joshua-naidoo/NIFLS/Hardware/Baseplate/BASEPLATE_CAD_Package_Revision_C/LED_and_resistor_coordinates.csv

type | ID | string_ID | x_mm | y_mm | hole_spacing_mm | hole_diameter_mm
LED | D1 | S1 | -67.5 | -66.0 | 2.54 | 1.1
LED | D2 | S1 | -67.5 | -49.5 | 2.54 | 1.1
LED | D3 | S1 | -67.5 | -33.0 | 2.54 | 1.1
LED | D4 | S2 | -67.5 | -16.5 | 2.54 | 1.1
LED | D5 | S2 | -67.5 | 0.0 | 2.54 | 1.1
LED | D6 | S2 | -67.5 | 16.5 | 2.54 | 1.1
LED | D7 | S3 | -67.5 | 33.0 | 2.54 | 1.1
LED | D8 | S3 | -67.5 | 49.5 | 2.54 | 1.1
LED | D9 | S3 | -67.5 | 66.0 | 2.54 | 1.1
resistor | R1 | S1 | -67.5 | -72.5 | 10 | 1.1
resistor | R2 | S2 | -67.5 | -23.0 | 10 | 1.1
resistor | R3 | S3 | -67.5 | 26.5 | 10 | 1.1
LED | D10 | S4 | -54.0 | -66.0 | 2.54 | 1.1
LED | D11 | S4 | -54.0 | -49.5 | 2.54 | 1.1
LED | D12 | S4 | -54.0 | -33.0 | 2.54 | 1.1
LED | D13 | S5 | -54.0 | -16.5 | 2.54 | 1.1
LED | D14 | S5 | -54.0 | 0.0 | 2.54 | 1.1
LED | D15 | S5 | -54.0 | 16.5 | 2.54 | 1.1
LED | D16 | S6 | -54.0 | 33.0 | 2.54 | 1.1
LED | D17 | S6 | -54.0 | 49.5 | 2.54 | 1.1
LED | D18 | S6 | -54.0 | 66.0 | 2.54 | 1.1
resistor | R4 | S4 | -54.0 | -72.5 | 10 | 1.1
resistor | R5 | S5 | -54.0 | -23.0 | 10 | 1.1
resistor | R6 | S6 | -54.0 | 26.5 | 10 | 1.1
LED | D19 | S7 | -40.5 | -66.0 | 2.54 | 1.1
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
