joshua-naidoo/NIFLS/Hardware/Baseplate/BASEPLATE_CAD_Package_Revision_C/NIFLS_battery_access.png

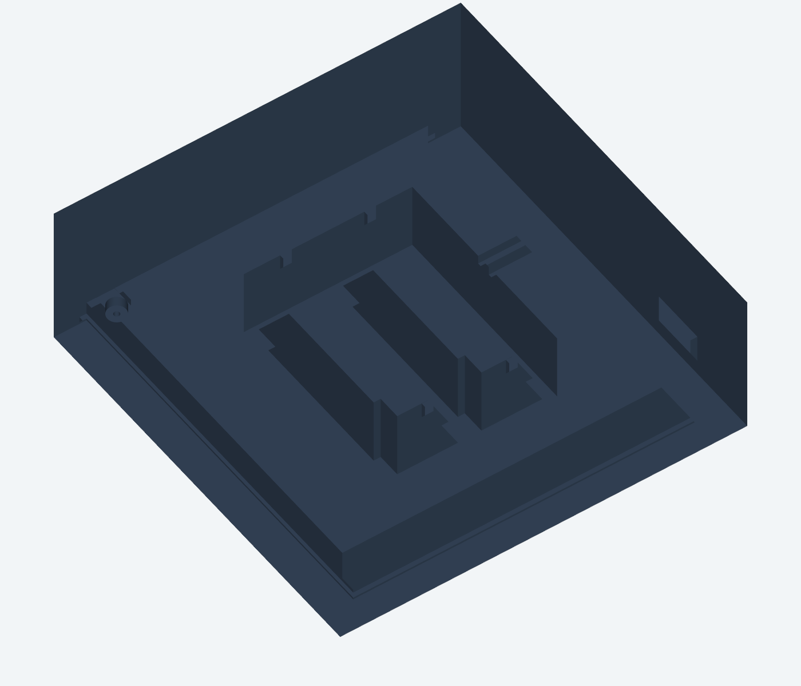
Hardware/Baseplate/BASEPLATE_CAD_Package_Revision_C/NIFLS_battery_access.png
