joshua-naidoo/NIFLS/Hardware/Phantom/Mold Smooth/bone_preview.png

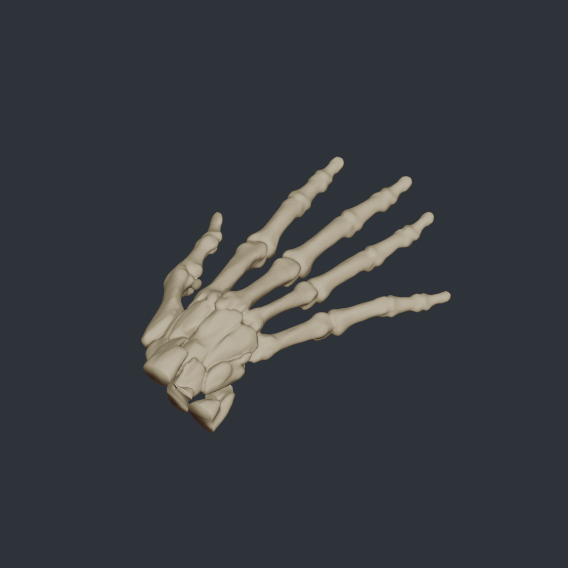
Hardware/Phantom/Mold Smooth/bone_preview.png
