joshua-naidoo/NIFLS/Hardware/Phantom/Mold Smooth/hand_preview.png

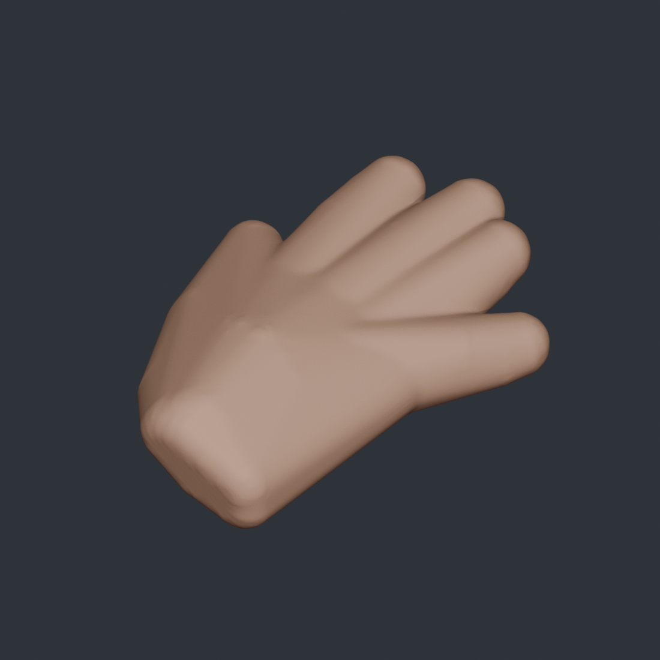
Hardware/Phantom/Mold Smooth/hand_preview.png
