joshua-naidoo/NIFLS/Hardware/Phantom/Mold Smooth/hand_reverse_preview.png

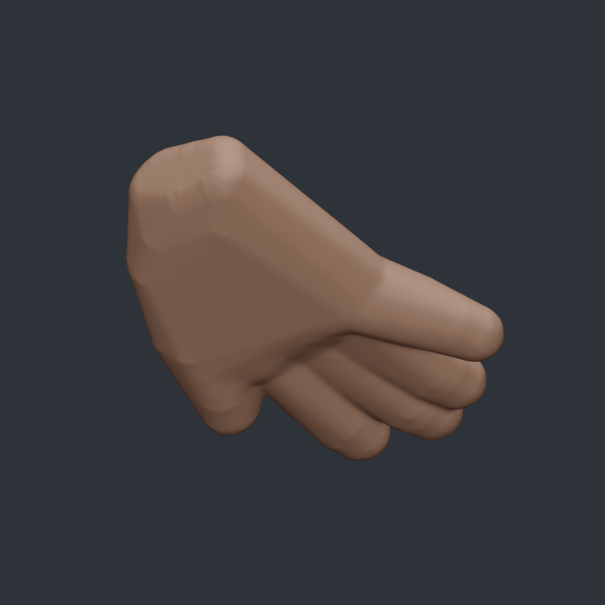
Hardware/Phantom/Mold Smooth/hand_reverse_preview.png
