joshua-naidoo/NIFLS/Hardware/Phantom/Mold Smooth/MINI_plate_preview.png

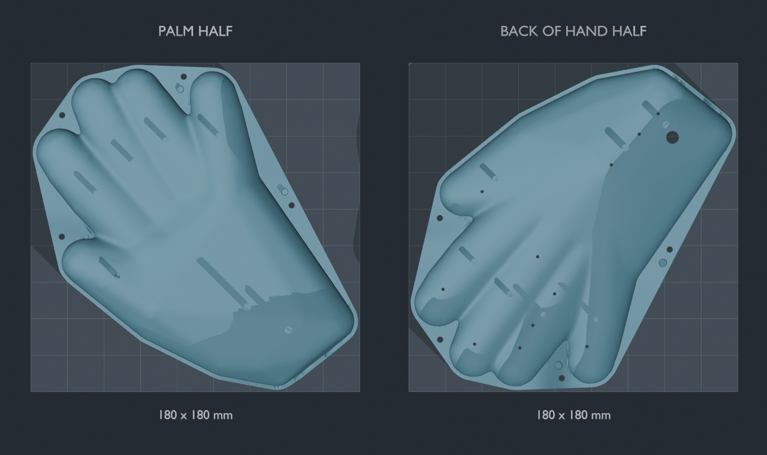
Hardware/Phantom/Mold Smooth/MINI_plate_preview.png
