joshua-naidoo/NIFLS/Hardware/Phantom/Mold Smooth/mold_preview.png

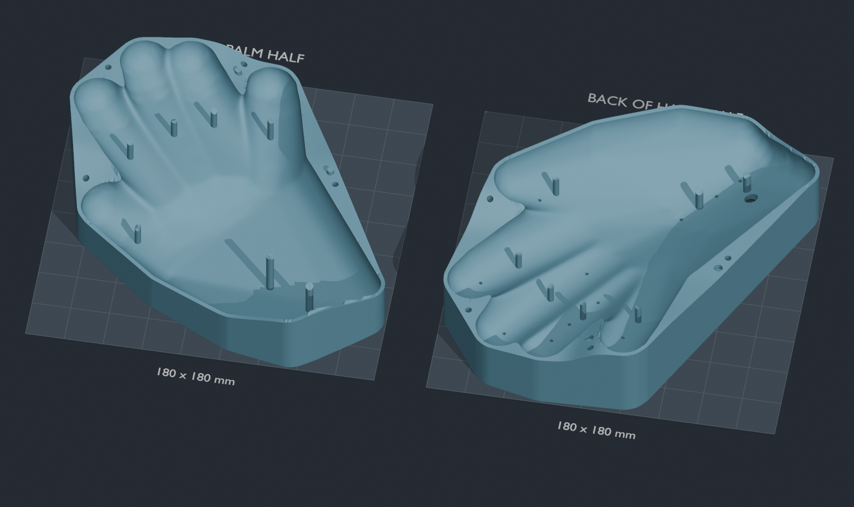
Hardware/Phantom/Mold Smooth/mold_preview.png
