joshua-naidoo/NIFLS/Hardware/Phantom/Mold Smooth/Screenshot 2026-09-13 161149.png

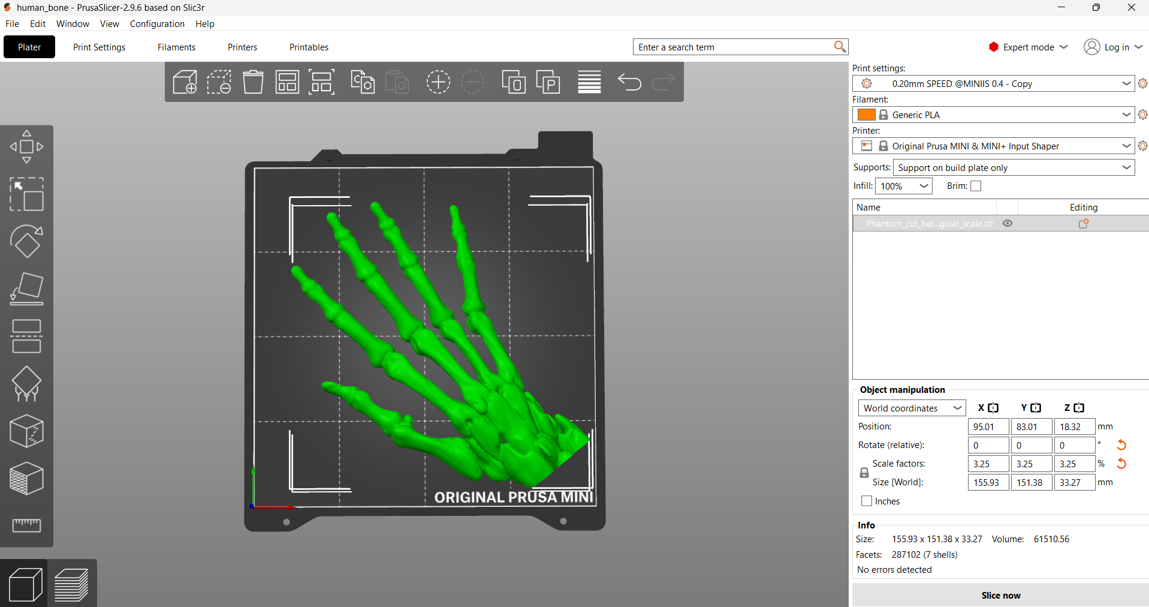
Hardware/Phantom/Mold Smooth/Screenshot 2026-09-13 161149.png
