joshua-naidoo/NIFLS/Hardware/Scanner/NIFLS_scanner_R16_STL_STEP/NIFLS_scanner_R16/NIFLS_R16_assembled.step

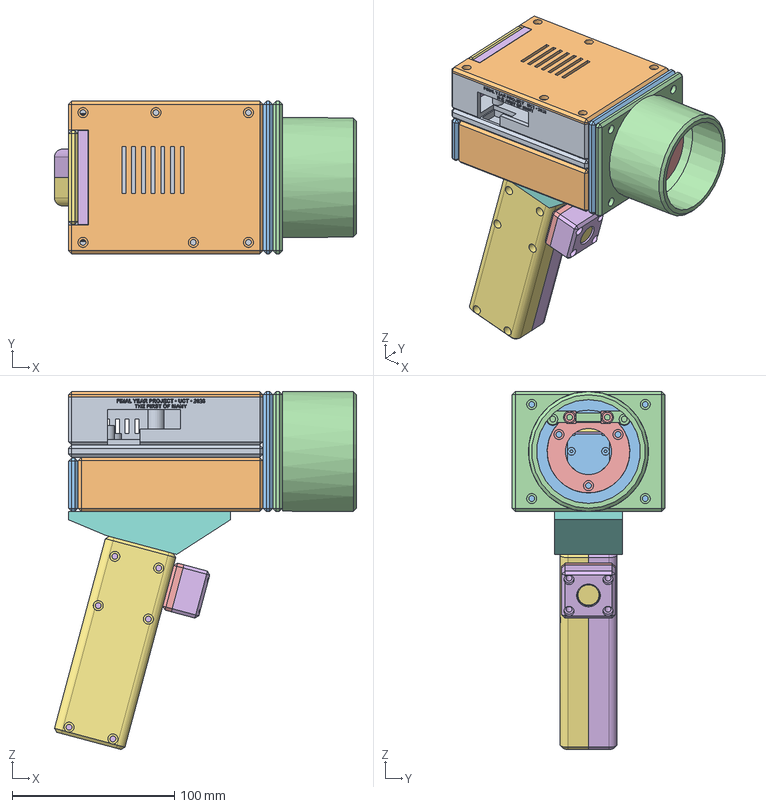
[picture p9: CAD file, 2026-10-17]
Hardware/Scanner/NIFLS_scanner_R16_STL_STEP/NIFLS_scanner_R16/NIFLS_R16_assembled.step
186.2 x 94.0 x 220.6 mm
01_pi_base
02_pi_lid
03_camera_bulkhead
04_contact_hood_35mm
06_filter_retainer
07_grip_insert_half
08_grip_screw_half
09_angled_saddle
22_battery_roof
23_battery_tray
24_battery_rear_cover
25_connector_access_cover
12_button_backplate
13_button_pod
14_button_cap
15_switch_cradle
16_switch_shim_0p4_print_2_A
16_switch_shim_0p4_print_2_B
10_alignment_key_print_2_A
10_alignment_key_print_2_B
05_filter_carrier_zomei_33x6
17_tof_cradle
18_tof_edge_clamp_print_2_A
18_tof_edge_clamp_print_2_B
19_power_pod
20_power_panel
21_led_retainer
