joshua-naidoo/NIFLS/Hardware/Baseplate/BASEPLATE_CAD_Package_Revision_C/NIFLS_assembly.step

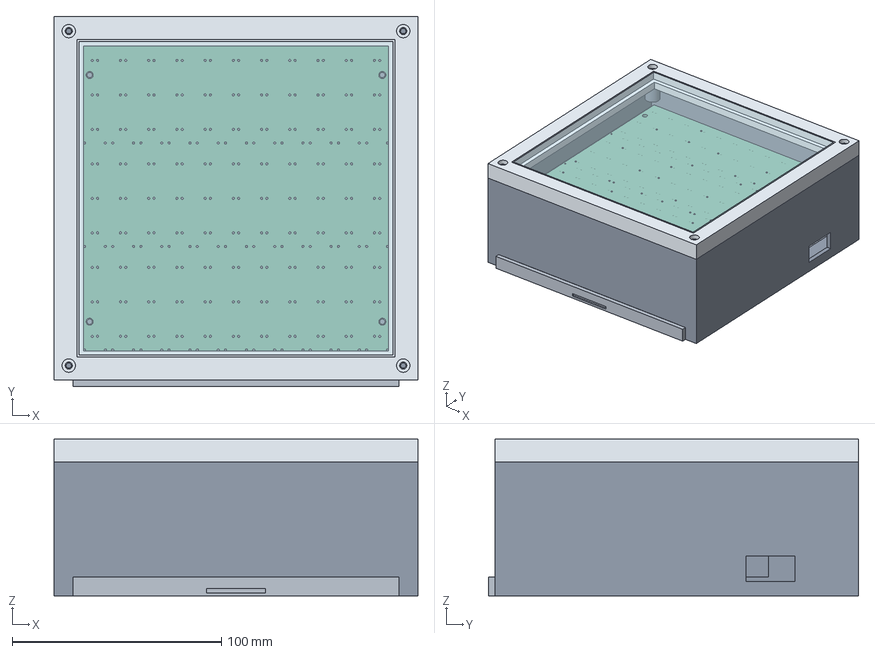
[picture p10: CAD file, 2026-10-17]
Hardware/Baseplate/BASEPLATE_CAD_Package_Revision_C/NIFLS_assembly.step
174.0 x 177.0 x 75.0 mm
01_diffuser_frame
02_LED_substrate
03_base_for_two_4AA_holders
04_sliding_battery_door
REFERENCE_only_150x150x6_glass
