joshua-naidoo/NIFLS/Hardware/Baseplate/BASEPLATE_CAD_Package_Revision_C/02_LED_substrate.step

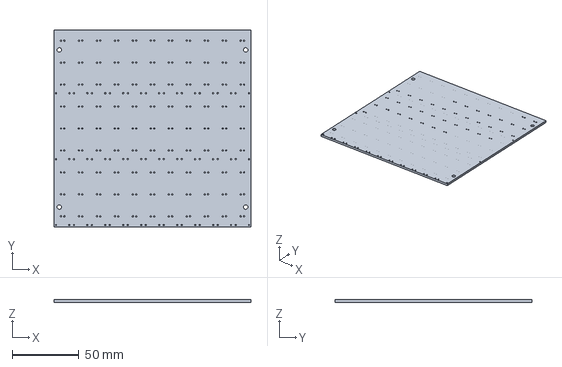
[picture p12: CAD file, 2026-10-17]
Hardware/Baseplate/BASEPLATE_CAD_Package_Revision_C/02_LED_substrate.step
148.0 x 148.0 x 2.00 mm
