joshua-naidoo/NIFLS/Hardware/Phantom/Mold Smooth/03_cast_hand_surface_REFERENCE.stl

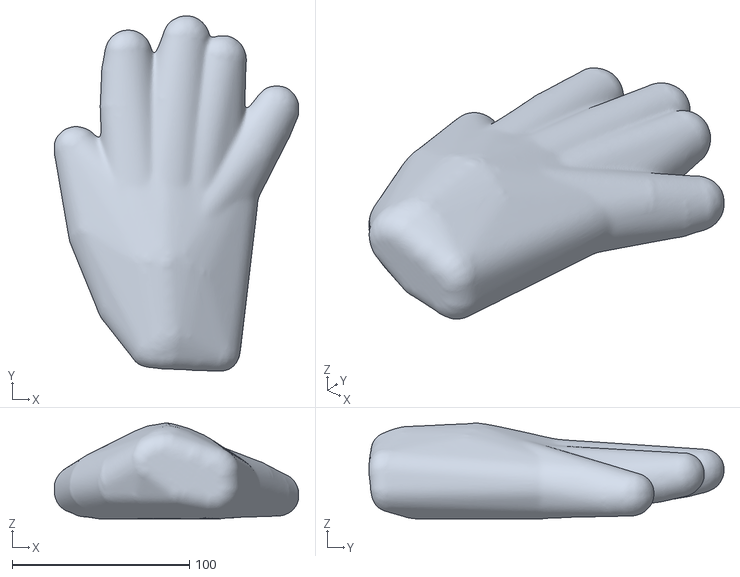
[picture p13: CAD file, 2026-10-17]
Hardware/Phantom/Mold Smooth/03_cast_hand_surface_REFERENCE.stl
138.0 x 200.4 x 54.0
