joshua-naidoo/NIFLS/Hardware/Scanner/NIFLS_scanner_R16_STL_STEP/NIFLS_scanner_R16/STEP_parts/15_switch_cradle.step

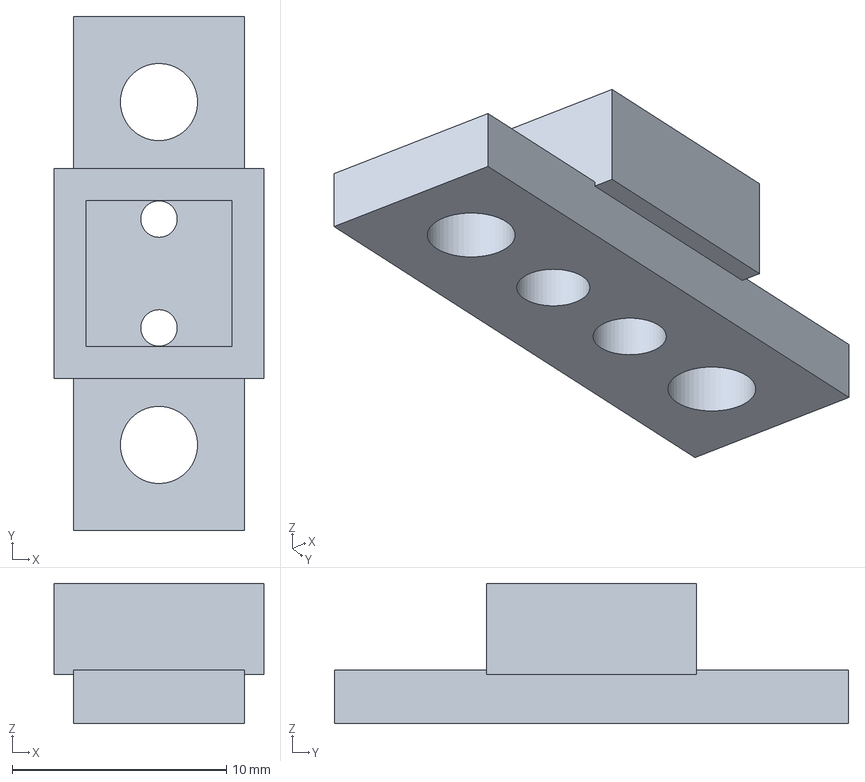
[picture p14: CAD file, 2026-10-17]
Hardware/Scanner/NIFLS_scanner_R16_STL_STEP/NIFLS_scanner_R16/STEP_parts/15_switch_cradle.step
9.80 x 24.0 x 6.55 mm
