joshua-naidoo/NIFLS/Hardware/Baseplate/BASEPLATE_CAD_Package_Revision_C/01_diffuser_frame.step

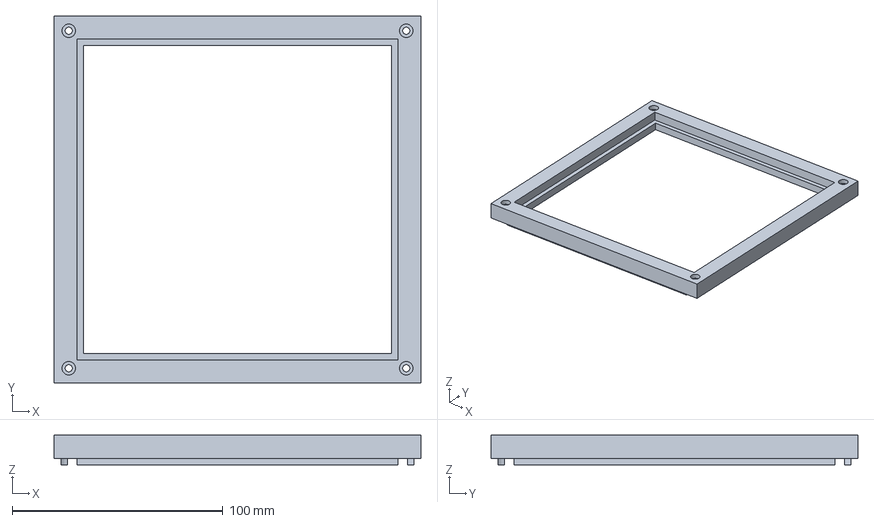
[picture p15: CAD file, 2026-10-17]
Hardware/Baseplate/BASEPLATE_CAD_Package_Revision_C/01_diffuser_frame.step
174.0 x 174.0 x 14.0 mm
