joshua-naidoo/NIFLS/Hardware/Phantom/Mold Smooth/04_bone_EXACT_SOURCE_REFERENCE.stl

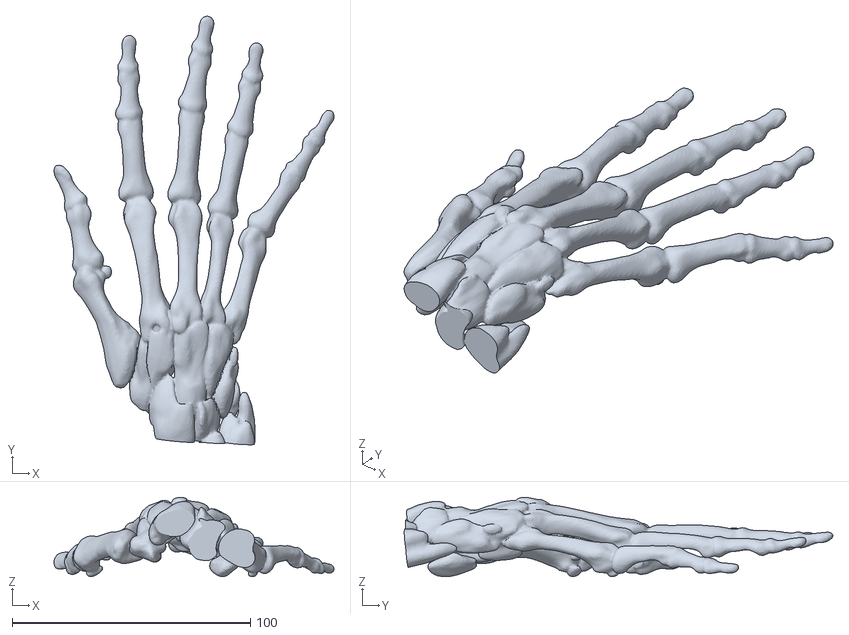
[picture p16: CAD file, 2026-10-17]
Hardware/Phantom/Mold Smooth/04_bone_EXACT_SOURCE_REFERENCE.stl
117.6 x 180.0 x 33.3
