joshua-naidoo/NIFLS/Hardware/Scanner/NIFLS_scanner_R16_STL_STEP/NIFLS_scanner_R16/STEP_parts/05_filter_carrier_zomei_33x6.step

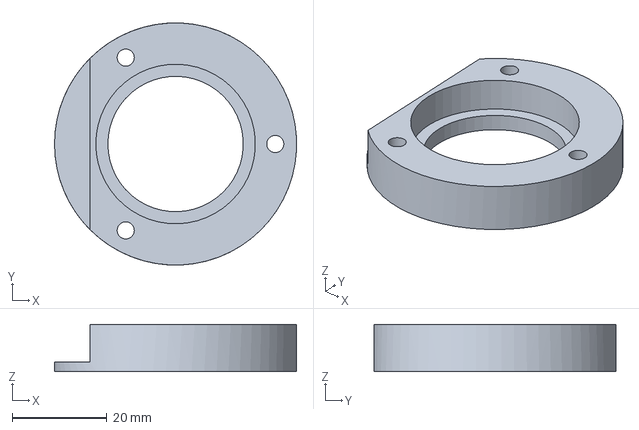
[picture p17: CAD file, 2026-10-17]
Hardware/Scanner/NIFLS_scanner_R16_STL_STEP/NIFLS_scanner_R16/STEP_parts/05_filter_carrier_zomei_33x6.step
51.0 x 51.0 x 9.90 mm
