joshua-naidoo/NIFLS/Hardware/Phantom/Mold Smooth/02_mold_upper_MINI_DIAGONAL.3mf

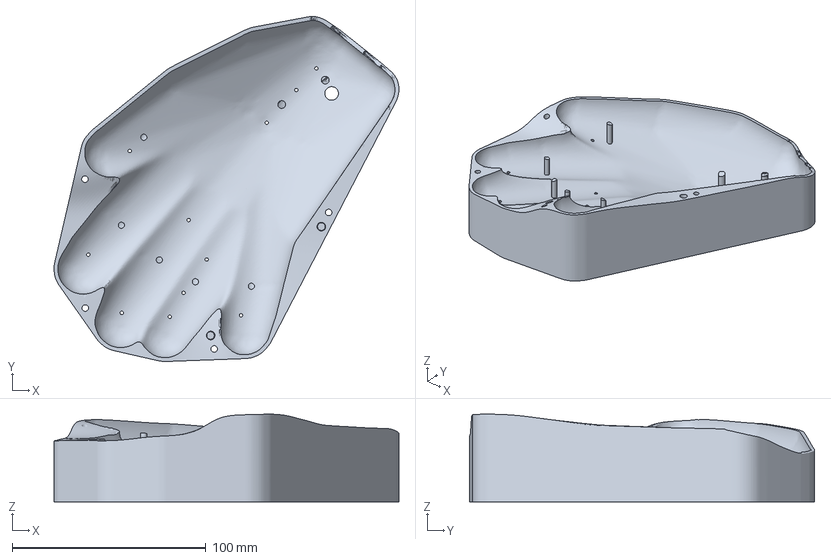
[picture p18: CAD file, 2026-10-17]
Hardware/Phantom/Mold Smooth/02_mold_upper_MINI_DIAGONAL.3mf
178.2 x 178.2 x 45.4 mm
