joshua-naidoo/NIFLS/Hardware/Scanner/NIFLS_scanner_R16_STL_STEP/NIFLS_scanner_R16/STEP_parts/02_pi_lid.step

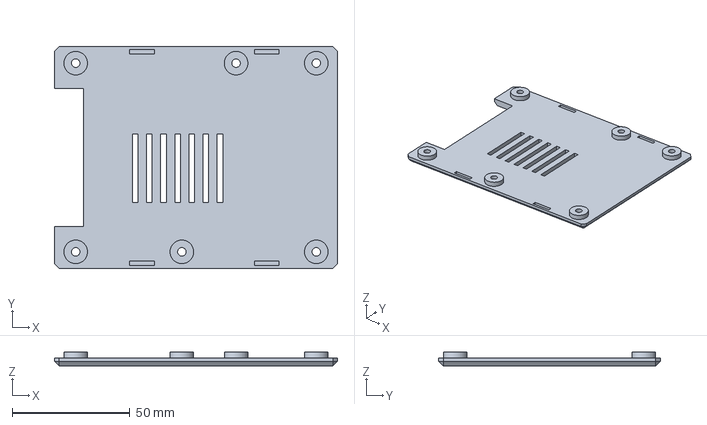
[picture p19: CAD file, 2026-10-17]
Hardware/Scanner/NIFLS_scanner_R16_STL_STEP/NIFLS_scanner_R16/STEP_parts/02_pi_lid.step
120.0 x 94.0 x 6.00 mm
