joshua-naidoo/NIFLS/Hardware/Phantom/Mold Smooth/human_bone.3mf

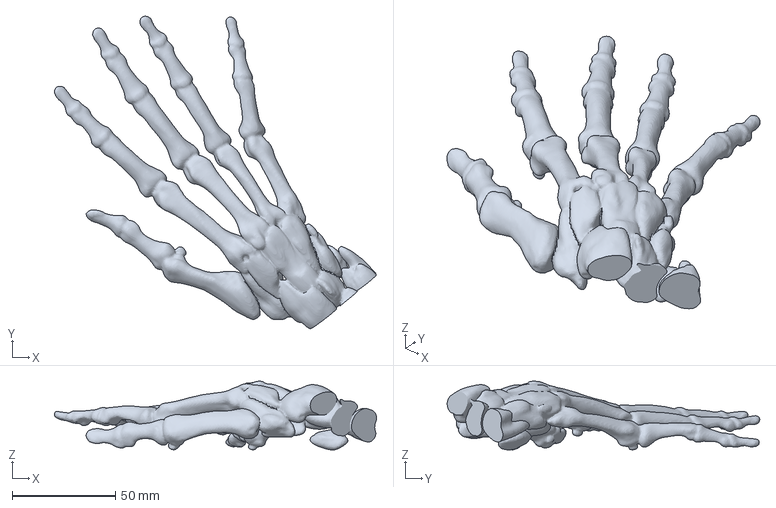
[picture p20: CAD file, 2026-10-17]
Hardware/Phantom/Mold Smooth/human_bone.3mf
155.9 x 151.4 x 33.3 mm
