joshua-naidoo/NIFLS/Hardware/Scanner/NIFLS_scanner_R16_STL_STEP/NIFLS_scanner_R16/STEP_parts/13_button_pod.step

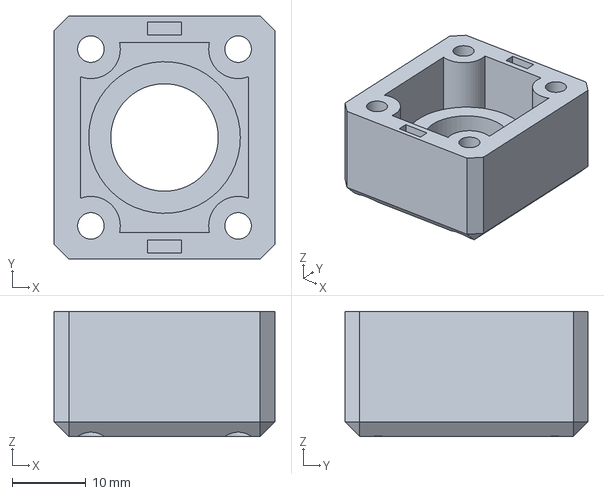
[picture p21: CAD file, 2026-10-17]
Hardware/Scanner/NIFLS_scanner_R16_STL_STEP/NIFLS_scanner_R16/STEP_parts/13_button_pod.step
30.0 x 33.0 x 17.0 mm
