joshua-naidoo/NIFLS/Hardware/Baseplate/BASEPLATE_CAD_Package_Revision_C/03_base_for_two_4AA_holders.step

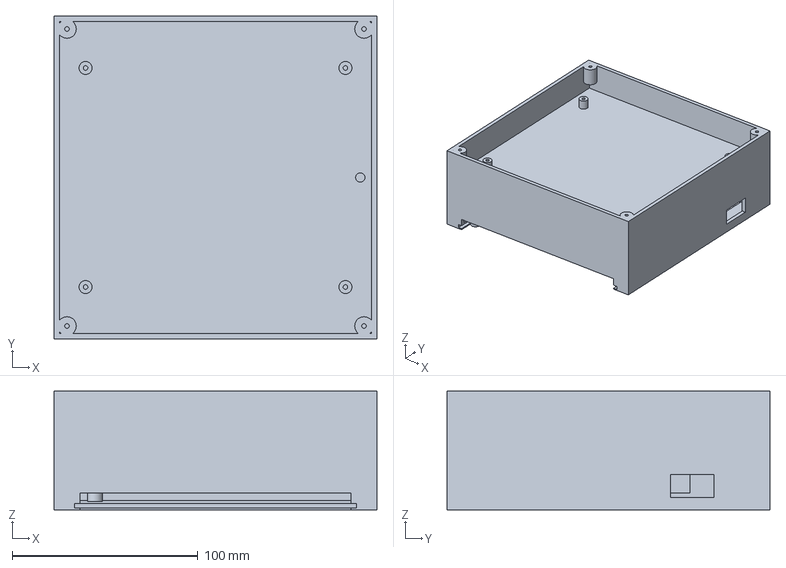
[picture p22: CAD file, 2026-10-17]
Hardware/Baseplate/BASEPLATE_CAD_Package_Revision_C/03_base_for_two_4AA_holders.step
174.0 x 174.0 x 64.0 mm
