joshua-naidoo/NIFLS/Hardware/Phantom/Mold Smooth/01_mold_lower_MINI_DIAGONAL.3mf

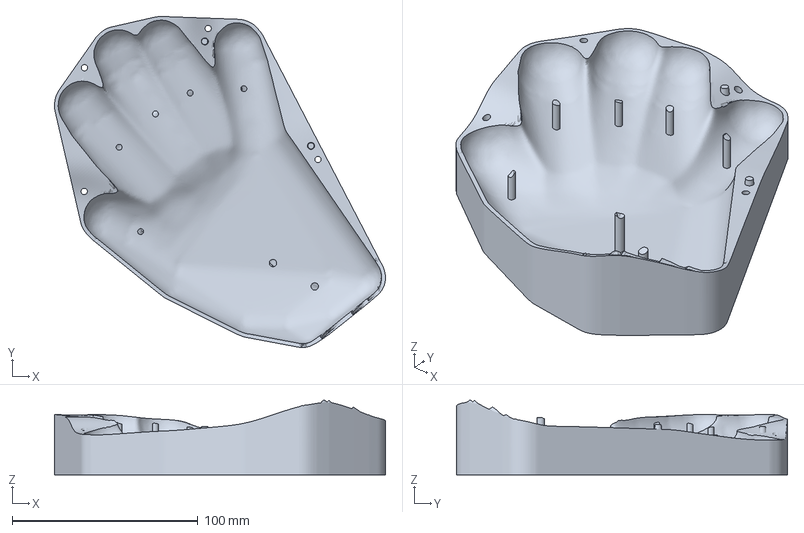
[picture p23: CAD file, 2026-10-17]
Hardware/Phantom/Mold Smooth/01_mold_lower_MINI_DIAGONAL.3mf
178.2 x 178.2 x 40.3 mm
