joshua-naidoo/NIFLS/Hardware/Baseplate/BASEPLATE_CAD_Package_Revision_C/04_sliding_battery_door.step

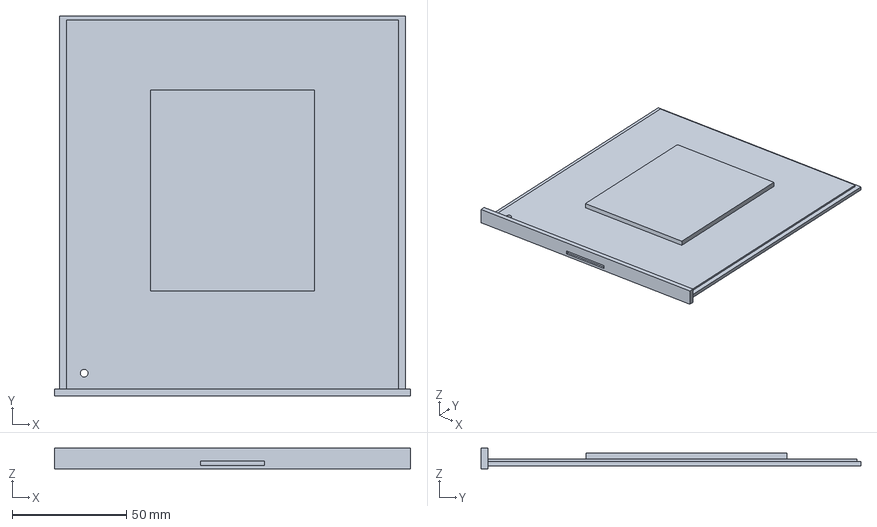
[picture p24: CAD file, 2026-10-17]
Hardware/Baseplate/BASEPLATE_CAD_Package_Revision_C/04_sliding_battery_door.step
156.0 x 166.5 x 9.00 mm
