joshua-naidoo/NIFLS/Hardware/Scanner/NIFLS_scanner_R16_STL_STEP/NIFLS_scanner_R16/STEP_parts/19_power_pod.step

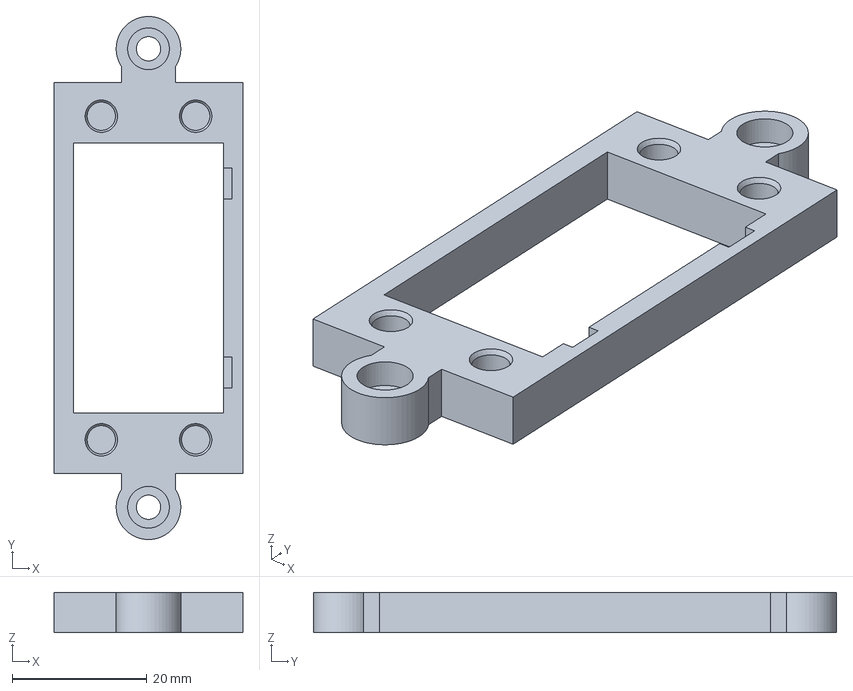
[picture p25: CAD file, 2026-10-17]
Hardware/Scanner/NIFLS_scanner_R16_STL_STEP/NIFLS_scanner_R16/STEP_parts/19_power_pod.step
28.0 x 77.6 x 6.00 mm
