joshua-naidoo/NIFLS/Hardware/Baseplate/BASEPLATE_CAD_Package_Revision_C/switch_fit_coupon_23p4x12p4.step

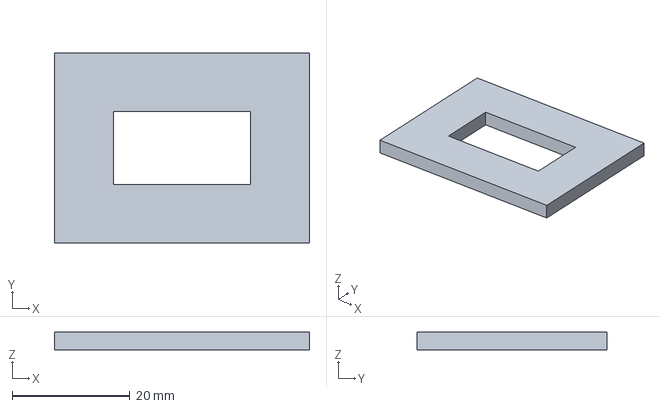
[picture p27: CAD file, 2026-10-17]
Hardware/Baseplate/BASEPLATE_CAD_Package_Revision_C/switch_fit_coupon_23p4x12p4.step
43.4 x 32.4 x 3.00 mm
