joshua-naidoo/NIFLS/Hardware/Scanner/NIFLS_scanner_R16_STL_STEP/NIFLS_scanner_R16/STEP_parts/16_switch_shim_0p4_print_2.step

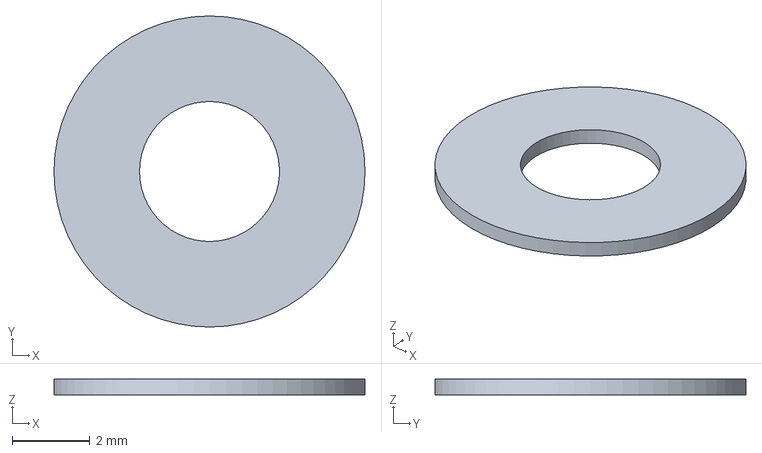
[picture p28: CAD file, 2026-10-17]
Hardware/Scanner/NIFLS_scanner_R16_STL_STEP/NIFLS_scanner_R16/STEP_parts/16_switch_shim_0p4_print_2.step
8.00 x 8.00 x 0.4 mm
