joshua-naidoo/NIFLS/Hardware/Baseplate/BASEPLATE_CAD_Package_Revision_C/holder_footprint_fit_coupon.step

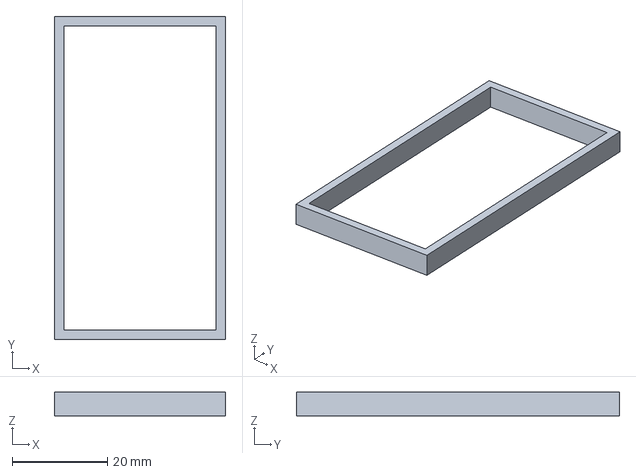
[picture p29: CAD file, 2026-10-17]
Hardware/Baseplate/BASEPLATE_CAD_Package_Revision_C/holder_footprint_fit_coupon.step
36.0 x 68.0 x 5.00 mm
