joshua-naidoo/NIFLS/Hardware/Scanner/NIFLS_scanner_R16_STL_STEP/NIFLS_scanner_R16/STEP_parts/18_tof_edge_clamp_print_2.step

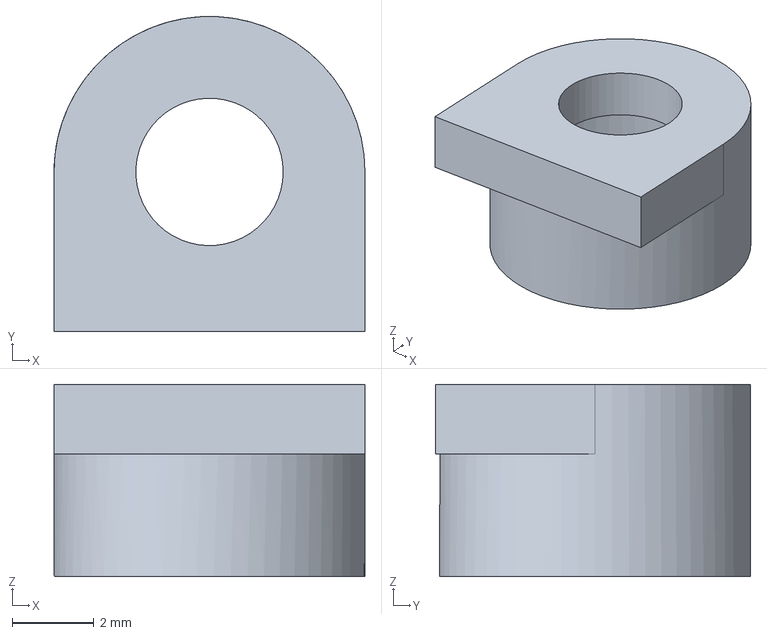
[picture p39: CAD file, 2026-10-17]
Hardware/Scanner/NIFLS_scanner_R16_STL_STEP/NIFLS_scanner_R16/STEP_parts/18_tof_edge_clamp_print_2.step
7.60 x 7.70 x 4.70 mm
