joshua-naidoo/NIFLS/(list of files, cad)

Other CAD files:
Hardware/Baseplate/BASEPLATE_CAD_Package_Revision_C/03_base_MINI_adhesion_trial.3mf
Hardware/Baseplate/BASEPLATE_CAD_Package_Revision_C/01_diffuser_frame.stl
Hardware/Baseplate/BASEPLATE_CAD_Package_Revision_C/02_LED_substrate.stl
Hardware/Baseplate/BASEPLATE_CAD_Package_Revision_C/03_base_for_two_4AA_holders.3mf
Hardware/Baseplate/BASEPLATE_CAD_Package_Revision_C/03_base_for_two_4AA_holders.stl
Hardware/Baseplate/BASEPLATE_CAD_Package_Revision_C/04_sliding_battery_door.stl
Hardware/Baseplate/BASEPLATE_CAD_Package_Revision_C/holder_footprint_fit_coupon.stl
Hardware/Baseplate/BASEPLATE_CAD_Package_Revision_C/switch_fit_coupon_23p4x12p4.stl
Hardware/Phantom/Mold Smooth/01_mold_lower_MINI_DIAGONAL.stl
Hardware/Phantom/Mold Smooth/02_mold_upper_MINI_DIAGONAL.stl
Hardware/Scanner/NIFLS_scanner_R16_STL_STEP/NIFLS_scanner_R16/STEP_parts/08_grip_screw_half.step
Hardware/Scanner/NIFLS_scanner_R16_STL_STEP/NIFLS_scanner_R16/STL/01_pi_base.stl
Hardware/Scanner/NIFLS_scanner_R16_STL_STEP/NIFLS_scanner_R16/STL/02_pi_lid.stl
Hardware/Scanner/NIFLS_scanner_R16_STL_STEP/NIFLS_scanner_R16/STL/03_camera_bulkhead.stl
Hardware/Scanner/NIFLS_scanner_R16_STL_STEP/NIFLS_scanner_R16/STL/04_contact_hood_35mm.stl
Hardware/Scanner/NIFLS_scanner_R16_STL_STEP/NIFLS_scanner_R16/STL/05_filter_carrier_zomei_33x6.stl
Hardware/Scanner/NIFLS_scanner_R16_STL_STEP/NIFLS_scanner_R16/STL/06_filter_retainer.stl
Hardware/Scanner/NIFLS_scanner_R16_STL_STEP/NIFLS_scanner_R16/STL/07_grip_insert_half.stl
Hardware/Scanner/NIFLS_scanner_R16_STL_STEP/NIFLS_scanner_R16/STL/08_grip_screw_half.stl
Hardware/Scanner/NIFLS_scanner_R16_STL_STEP/NIFLS_scanner_R16/STL/09_angled_saddle.stl
Hardware/Scanner/NIFLS_scanner_R16_STL_STEP/NIFLS_scanner_R16/STL/10_alignment_key_print_2.stl
Hardware/Scanner/NIFLS_scanner_R16_STL_STEP/NIFLS_scanner_R16/STL/11_insert_fit_coupon.stl
Hardware/Scanner/NIFLS_scanner_R16_STL_STEP/NIFLS_scanner_R16/STL/12_button_backplate.stl
Hardware/Scanner/NIFLS_scanner_R16_STL_STEP/NIFLS_scanner_R16/STL/13_button_pod.stl
Hardware/Scanner/NIFLS_scanner_R16_STL_STEP/NIFLS_scanner_R16/STL/14_button_cap.stl
Hardware/Scanner/NIFLS_scanner_R16_STL_STEP/NIFLS_scanner_R16/STL/15_switch_cradle.stl
Hardware/Scanner/NIFLS_scanner_R16_STL_STEP/NIFLS_scanner_R16/STL/16_switch_shim_0p4_print_2.stl
Hardware/Scanner/NIFLS_scanner_R16_STL_STEP/NIFLS_scanner_R16/STL/17_tof_cradle.stl
Hardware/Scanner/NIFLS_scanner_R16_STL_STEP/NIFLS_scanner_R16/STL/18_tof_edge_clamp_print_2.stl
Hardware/Scanner/NIFLS_scanner_R16_STL_STEP/NIFLS_scanner_R16/STL/19_power_pod.stl
Hardware/Scanner/NIFLS_scanner_R16_STL_STEP/NIFLS_scanner_R16/STL/20_power_panel.stl
Hardware/Scanner/NIFLS_scanner_R16_STL_STEP/NIFLS_scanner_R16/STL/21_led_retainer.stl
Hardware/Scanner/NIFLS_scanner_R16_STL_STEP/NIFLS_scanner_R16/STL/22_battery_roof.stl
Hardware/Scanner/NIFLS_scanner_R16_STL_STEP/NIFLS_scanner_R16/STL/23_battery_tray.stl
Hardware/Scanner/NIFLS_scanner_R16_STL_STEP/NIFLS_scanner_R16/STL/24_battery_rear_cover.stl
Hardware/Scanner/NIFLS_scanner_R16_STL_STEP/NIFLS_scanner_R16/STL/25_connector_access_cover.stl
