joshua-naidoo/NIFLS/Hardware/Baseplate/BASEPLATE_CAD_Package_Revision_C/NIFLS_holders_installed.png

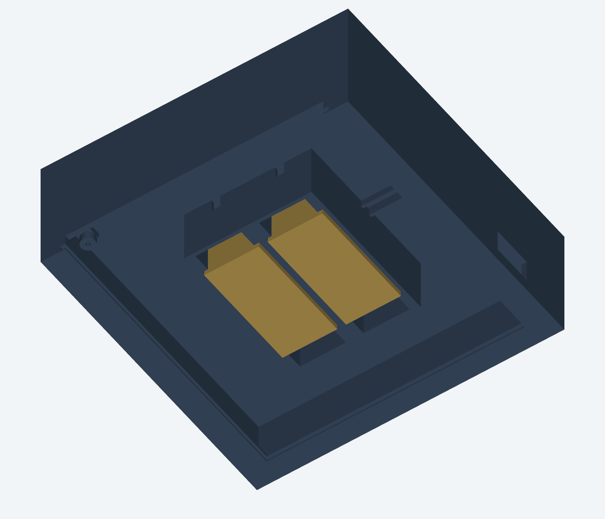
Hardware/Baseplate/BASEPLATE_CAD_Package_Revision_C/NIFLS_holders_installed.png
