joshua-naidoo/NIFLS/Software/experiment 3/exp3_table_rows.tex

JPEG encode (Pi) & 8.5 & 0.5 & 5.1 & 9.9 & 8.8 \\
Wait for send slot (Pi) & 0.3 & 0.0 & 0.2 & 0.5 & 0.3 \\
Network transfer (Wi-Fi/ZeroMQ) & 7.2 & 2.3 & 4.2 & 21.9 & 12.0 \\
JPEG decode + resize + rotate & 14.0 & 2.5 & 9.5 & 23.8 & 19.5 \\
Wait for inference thread & 19.0 & 9.4 & 2.6 & 44.3 & 35.0 \\
Pre-processing (CLAHE, resize, normalise) & 18.8 & 3.9 & 13.6 & 39.9 & 27.4 \\
U-Net inference & 181.1 & 56.9 & 121.7 & 730.4 & 265.5 \\
Post-processing & 1.7 & 1.2 & 0.8 & 16.0 & 3.3 \\
Render and display & 150.8 & 36.4 & 89.8 & 272.5 & 202.7 \\
End-to-end (frame delivered -> displayed) & 401.3 & 71.5 & 293.3 & 1000.6 & 516.1 \\
