joshua-naidoo/NIFLS/Software/experiment 1/frames.csv

region | d_mm | image
Pinky | 27 | exp1_pinky.jpg
Pinky | 27 | exp1_pinky_frame1.jpg
Index finger | 32 | exp1_index.jpg
Thumb | 32 | exp1_thumb.jpg
Middle fingertip | 32 | exp1_middle_fingertip.jpg
Middle finger | 36 | exp1_middle_finger.jpg
Upper palm (b) | 40 | exp1_upper_palm_b.jpg
Upper palm (a) | 42 | exp1_upper_palm_a.jpg
Palm | 47 | exp1_palm.jpg
