joshua-naidoo/NIFLS/Software/experiment 1/results/exp1_fit.csv

region | d_mm | roi_grey | rel_intensity_linear | minus_ln_rel
Pinky | 27.0 | 202.8969955444336 | 1.0 | -0.0
Index finger | 32.0 | 179.5472412109375 | 0.7641645113827512 | 0.26897218396057104
Thumb | 32.0 | 176.1631622314453 | 0.7328361071647125 | 0.3108331939584751
Middle fingertip | 32.0 | 197.3236846923828 | 0.9405630662502967 | 0.061276576401707736
Middle finger | 36.0 | 124.33088684082031 | 0.3404611122961477 | 1.0774543675619033
Upper palm (b) | 40.0 | 138.87008666992188 | 0.434242972556429 | 0.8341510569361881
Upper palm (a) | 42.0 | 116.18506622314453 | 0.29330828205486864 | 1.2265310659106354
Palm | 47.0 | 70.7839126586914 | 0.09859381864776029 | 2.3167467105379083
