joshua-naidoo/NIFLS/Software/experiment 4/exp4_v3_cv_per_frame.csv

frame | positive | thr | dsc | iou | precision | recall | dsc_vs_undilated | detected | false_detect
fracture_s01_p01_20ms.jpg | True | 0.5 | 0.45269461077844314 | 0.29256965944272445 | 0.8669724770642202 | 0.3063209076175041 | 0.46894803548795944 | True | False
fracture_s01_p01_20ms.jpg | True | 0.85 | 0.36959370904325034 | 0.2266881028938907 | 0.9657534246575342 | 0.22852512155591573 | 0.39330543933054396 | True | False
fracture_s01_p03_20ms.jpg | True | 0.5 | 0.7384615384615385 | 0.5853658536585366 | 0.6772486772486772 | 0.8118393234672304 | 0.7242921013412816 | True | False
fracture_s01_p03_20ms.jpg | True | 0.85 | 0.743 | 0.5910898965791567 | 0.7049335863377609 | 0.7854122621564482 | 0.7294361096740818 | True | False
fracture_s01_p04_20ms.jpg | True | 0.5 | 0.9237961664329126 | 0.8583840139009556 | 0.8860986547085202 | 0.96484375 | 0.9072365225837785 | True | False
fracture_s01_p04_20ms.jpg | True | 0.85 | 0.9349633251833741 | 0.8778696051423324 | 0.9363369245837414 | 0.93359375 | 0.9312977099236641 | True | False
fracture_s01_p05_20ms.jpg | True | 0.5 | 0.766042780748663 | 0.6208017334777898 | 0.729936305732484 | 0.8059071729957806 | 0.7579972183588317 | True | False
fracture_s01_p05_20ms.jpg | True | 0.85 | 0.7647467036780013 | 0.6191011235955056 | 0.7547945205479452 | 0.7749648382559775 | 0.7563268257411424 | True | False
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
img_084.jpg | False | 0.85 |  |  |  |  |  | False | False
img_085.jpg | False | 0.5 |  |  |  |  |  | False | False
img_085.jpg | False | 0.85 |  |  |  |  |  | False | False
img_086.jpg | False | 0.5 |  |  |  |  |  | False | True
img_086.jpg | False | 0.85 |  |  |  |  |  | False | True
