joshua-naidoo/NIFLS/Software/experiment 3/host_latency_log.csv

frame | e2e_ms | enc_ms | send_wait_ms | transfer_ms | decode_ms | infer_wait_ms | pre_ms | model_ms | post_ms | display_ms | offset_s | cal_rtt_ms
1 | 330.5869579780847 | 5.252 | 0.22600000011152588 | 5.975258070975542 | 9.79939999524504 | 2.288699964992702 | 25.399900041520596 | 183.00359998829663 | 1.3264999724924564 | 97.31560002546757 | 575827.887336742 | 1.507122
7 | 366.07005808036774 | 4.872 | 0.20200000017212005 | 4.091858048923314 | 14.73739999346435 | 13.08409997727722 | 13.780700042843819 | 147.3087000194937 | 1.6923999646678567 | 166.30090004764497 | 575827.887336742 | 1.507122
12 | 289.07995799090713 | 4.866 | 0.197000000071057 | 5.359057919122279 | 9.955500019714236 | 15.891000046394765 | 14.765799976885319 | 112.64619999565184 | 2.7595999417826533 | 122.63980007264763 | 575827.887336742 | 1.507122
16 | 446.7505579814315 | 4.859 | 0.2009999998335843 | 3.3888579346239567 | 11.690399958752096 | 15.384900034405291 | 15.975099988281727 | 144.3662999663502 | 1.4183000894263387 | 249.46670001372695 | 575827.887336742 | 1.507122
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
