joshua-naidoo/NIFLS/Software/experiment 2/results/exp2_per_position.csv

peak_grey | flank_grey | michelson | max_abs_gradient | fwhm_px
1.037597314678453131e+02 | 9.250309094544043376e+01 | 5.735493041418157634e-02 | 1.377865523383384527e+00 | 4.400000000000000000e+01
1.037607087909285610e+02 | 9.208903039108130884e+01 | 5.959506736437551050e-02 | 1.336124283769422050e+00 | 4.200000000000000000e+01
1.037522938980170153e+02 | 9.187875586209237611e+01 | 6.069352513562875640e-02 | 1.309160921516969722e+00 | 4.200000000000000000e+01
1.037383874782725286e+02 | 9.171200872743246180e+01 | 6.153161612516102469e-02 | 1.235216119885770070e+00 | 3.800000000000000000e+01
1.038392520153555694e+02 | 9.159803345706274058e+01 | 6.263502140189318446e-02 | 1.143293932872076368e+00 | 3.600000000000000000e+01
1.037804315645375794e+02 | 9.176085828530308675e+01 | 6.146821107943247625e-02 | 1.105207872781562628e+00 | 3.600000000000000000e+01
1.037140088883042353e+02 | 9.187699401225410156e+01 | 6.051921970085845370e-02 | 1.213080240952436384e+00 | 3.600000000000000000e+01
1.035687202386013439e+02 | 9.186393775201587175e+01 | 5.989164046035450051e-02 | 1.221552310045261436e+00 | 3.600000000000000000e+01
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
