joshua-naidoo/NIFLS/Software/experiment 1/exp1_index.jpg

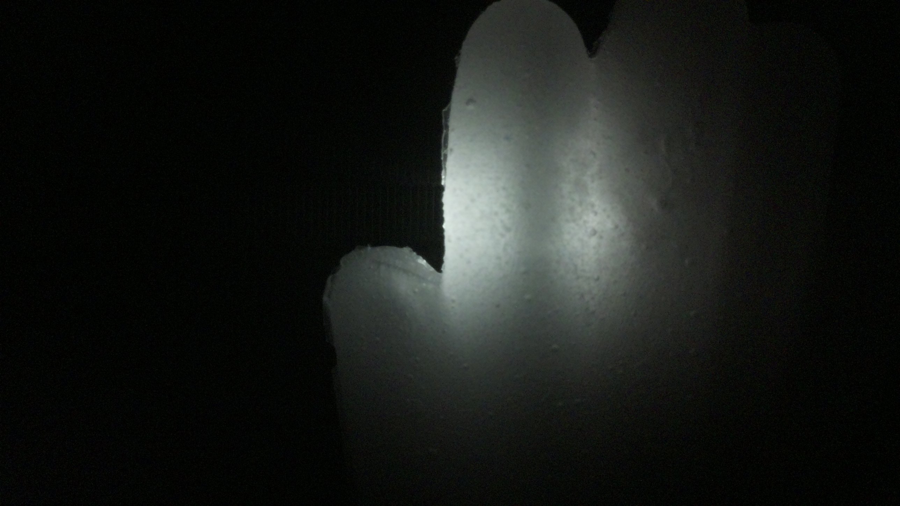
Software/experiment 1/exp1_index.jpg
