joshua-naidoo/NIFLS/Software/experiment 1/exp1_middle_finger.jpg

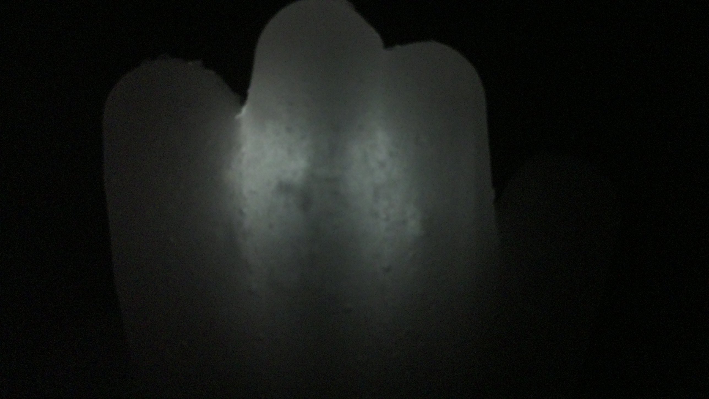
Software/experiment 1/exp1_middle_finger.jpg
