joshua-naidoo/NIFLS/Software/experiment 1/exp1_middle_fingertip.jpg

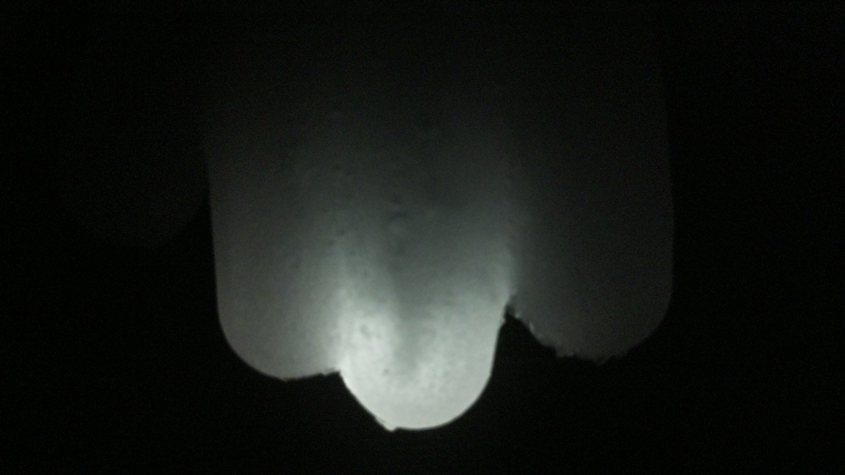
Software/experiment 1/exp1_middle_fingertip.jpg
