joshua-naidoo/NIFLS/Software/experiment 1/exp1_palm.jpg

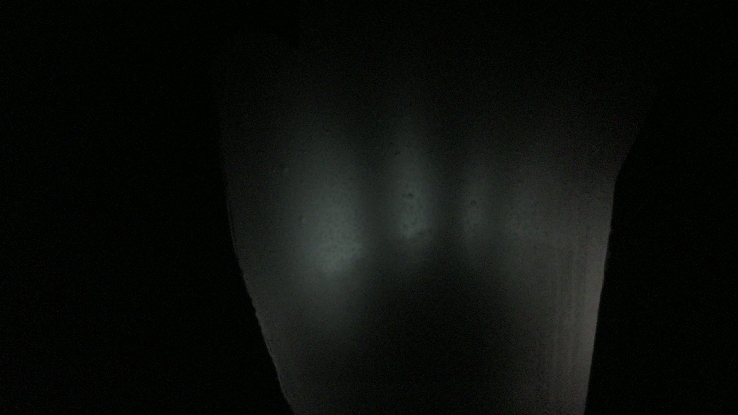
Software/experiment 1/exp1_palm.jpg
