joshua-naidoo/NIFLS/Software/experiment 1/exp1_pinky.jpg

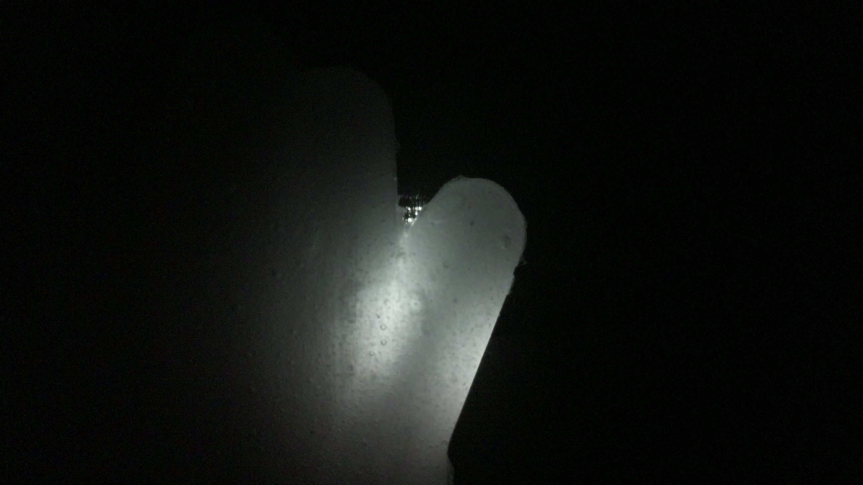
Software/experiment 1/exp1_pinky.jpg
