joshua-naidoo/NIFLS/Software/experiment 1/exp1_pinky_frame1.jpg

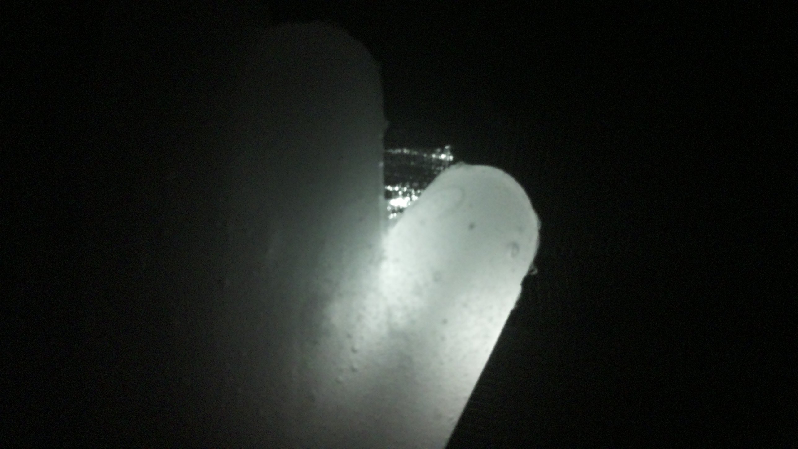
Software/experiment 1/exp1_pinky_frame1.jpg
