joshua-naidoo/NIFLS/Software/experiment 1/exp1_thumb.jpg

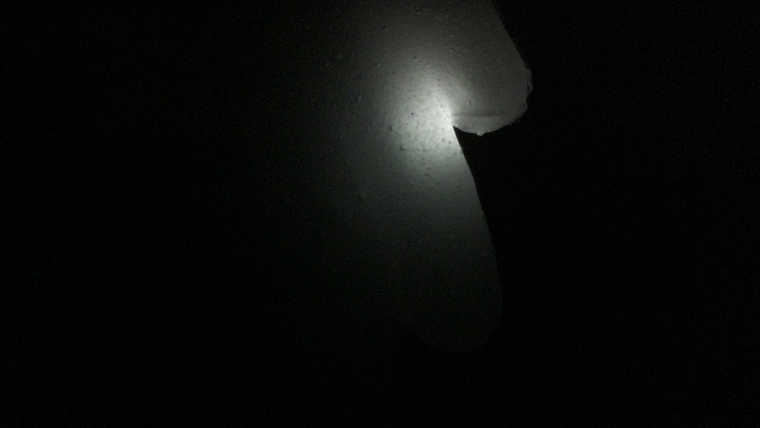
Software/experiment 1/exp1_thumb.jpg
