joshua-naidoo/NIFLS/Software/experiment 1/exp1_upper_palm_a.jpg

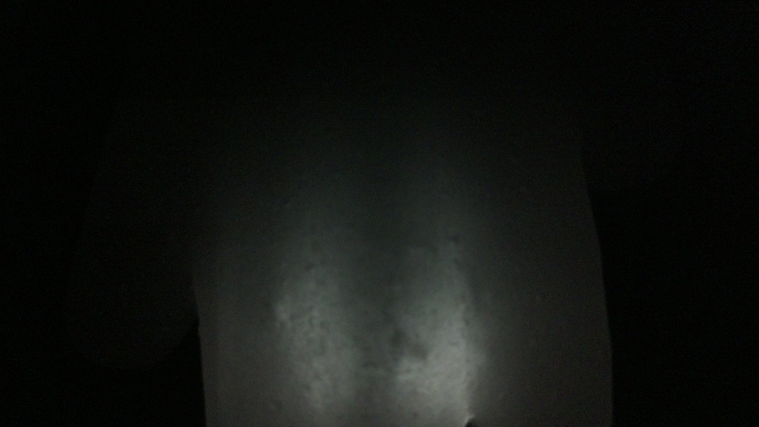
Software/experiment 1/exp1_upper_palm_a.jpg
