joshua-naidoo/NIFLS/Software/experiment 1/results/exp1_attenuation_fit.png

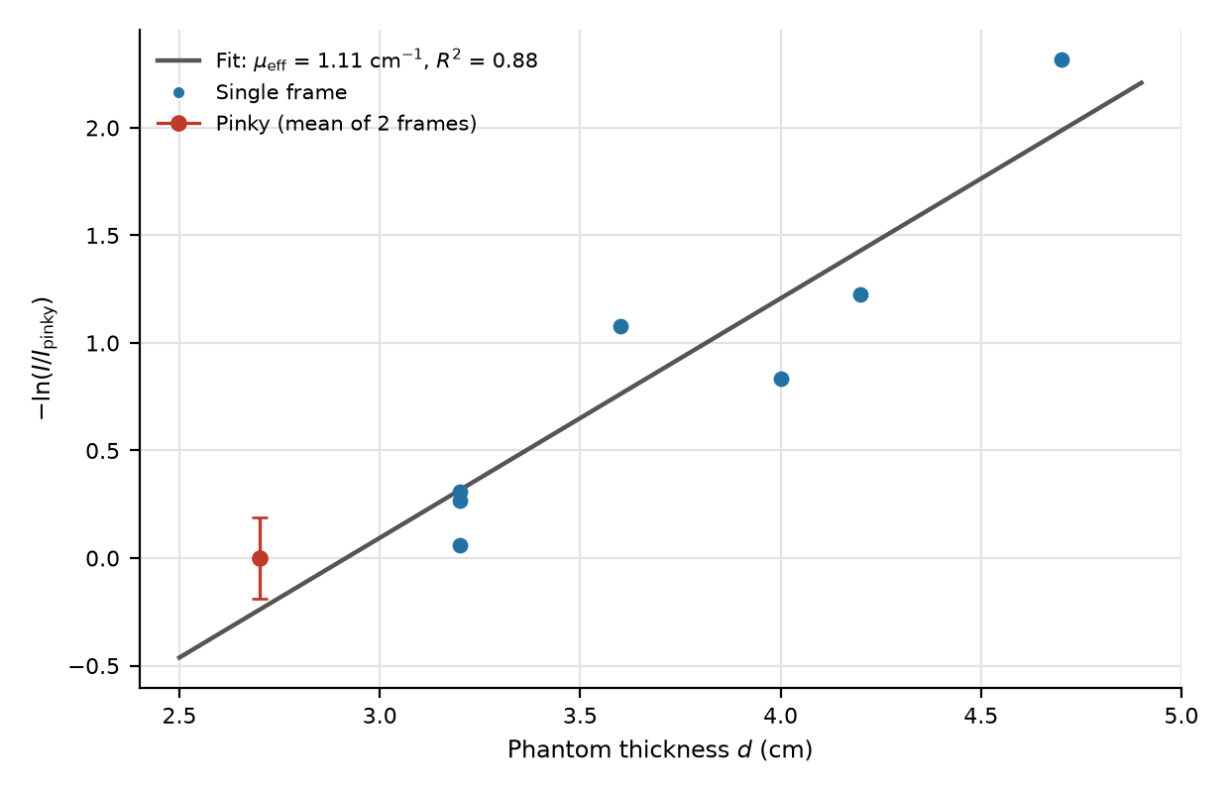
Software/experiment 1/results/exp1_attenuation_fit.png
