joshua-naidoo/NIFLS/Software/experiment 2/gap.jpg

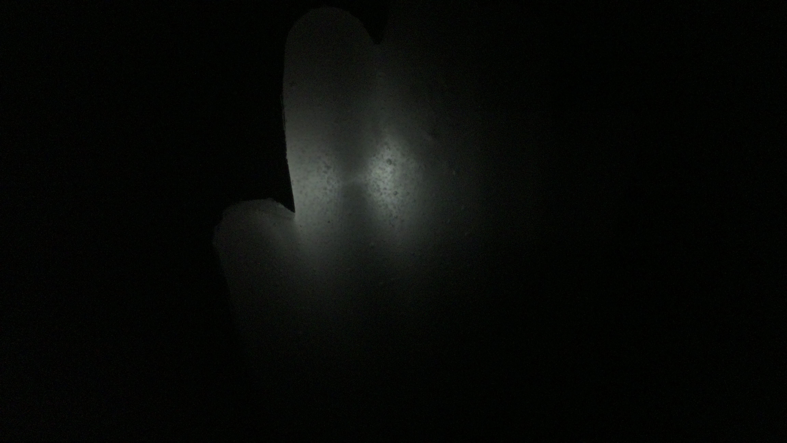
Software/experiment 2/gap.jpg
