joshua-naidoo/NIFLS/Software/experiment 2/results/exp2_comparison.png

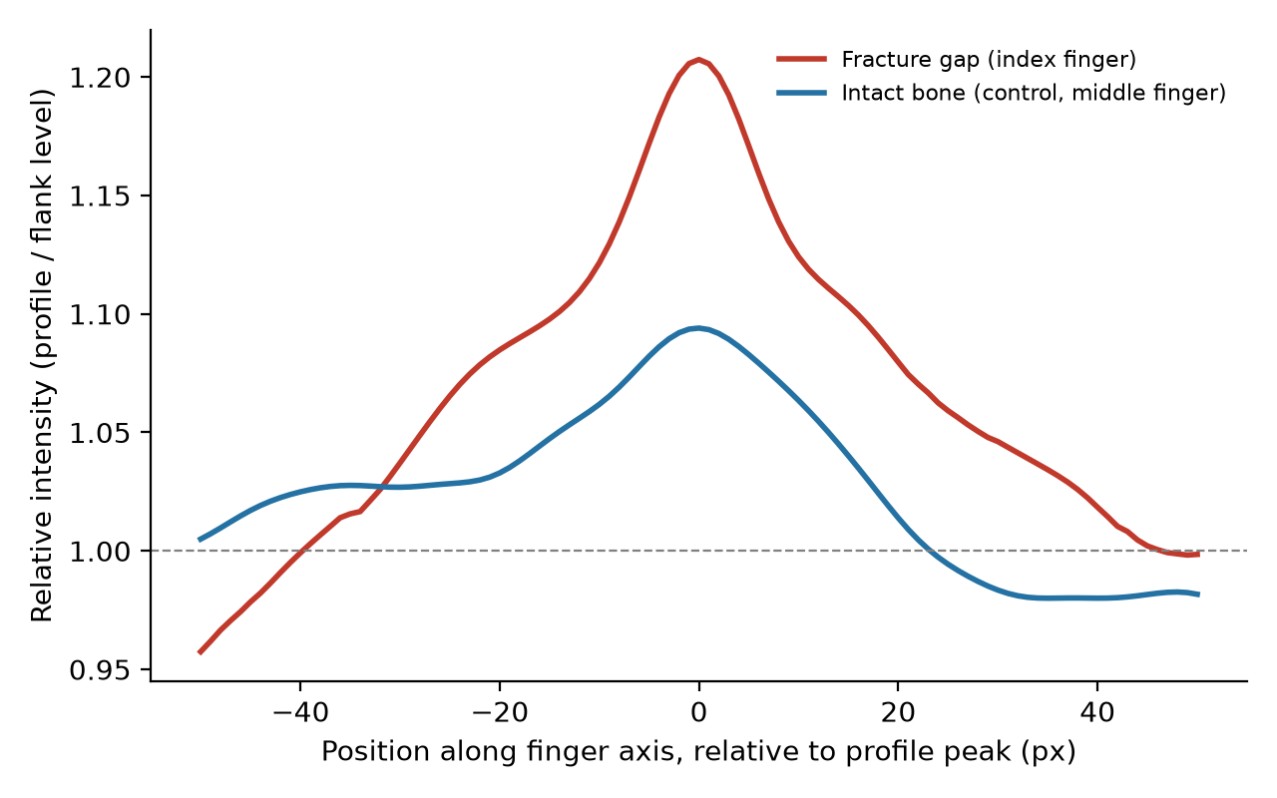
Software/experiment 2/results/exp2_comparison.png
