joshua-naidoo/NIFLS/Software/experiment 2/results/exp2_profile.png

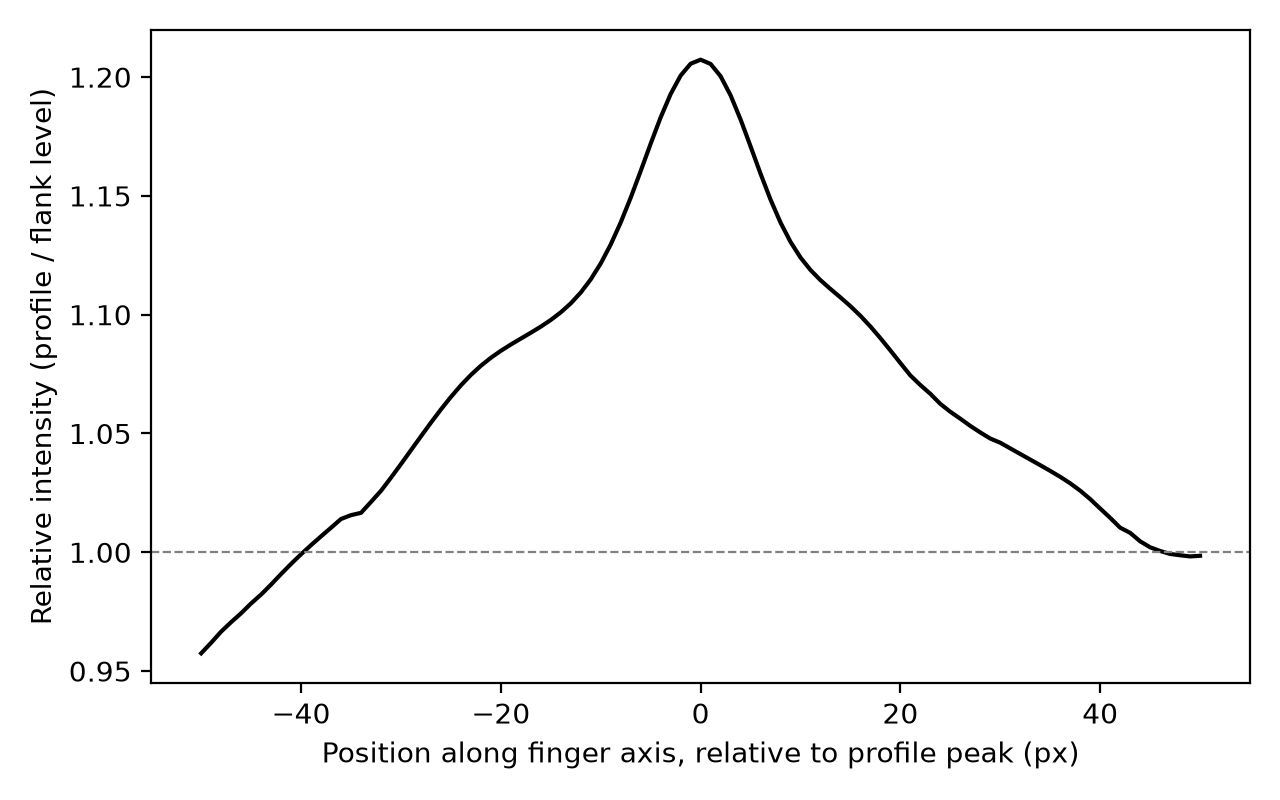
Software/experiment 2/results/exp2_profile.png
