joshua-naidoo/NIFLS/Software/experiment 3/exp3_latency_breakdown.png

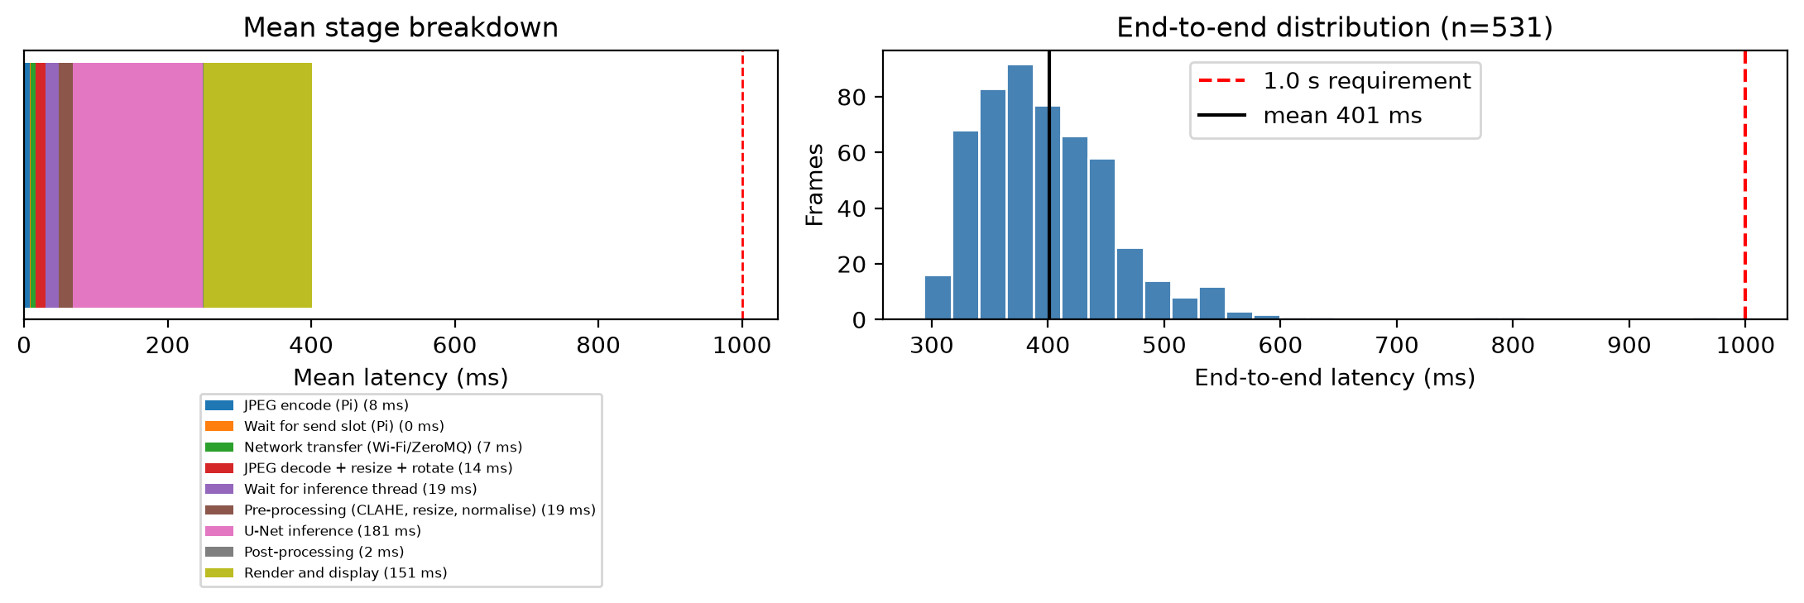
Software/experiment 3/exp3_latency_breakdown.png
