joshua-naidoo/NIFLS/Software/experiment 4/nifls_captures/nifls_20261001_105812.png

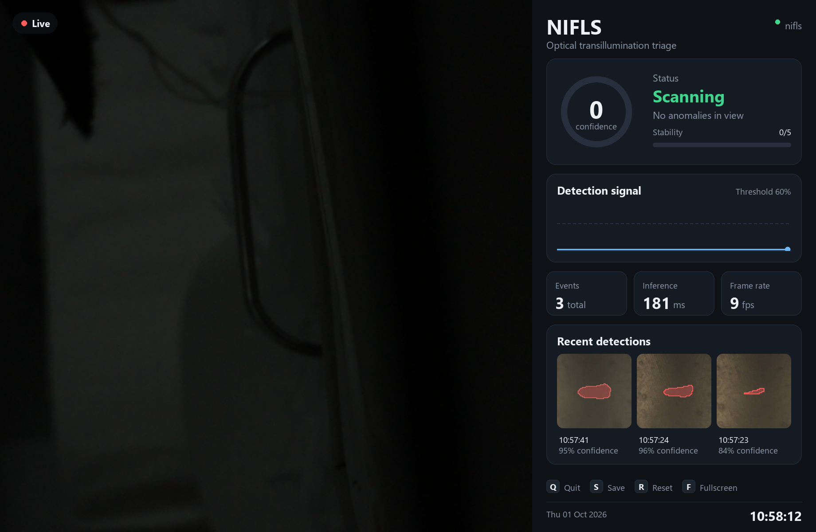
Software/experiment 4/nifls_captures/nifls_20261001_105812.png
