joshua-naidoo/NIFLS/Software/experiment 4/nifls_captures/nifls_screenshot_20261009_162345.png

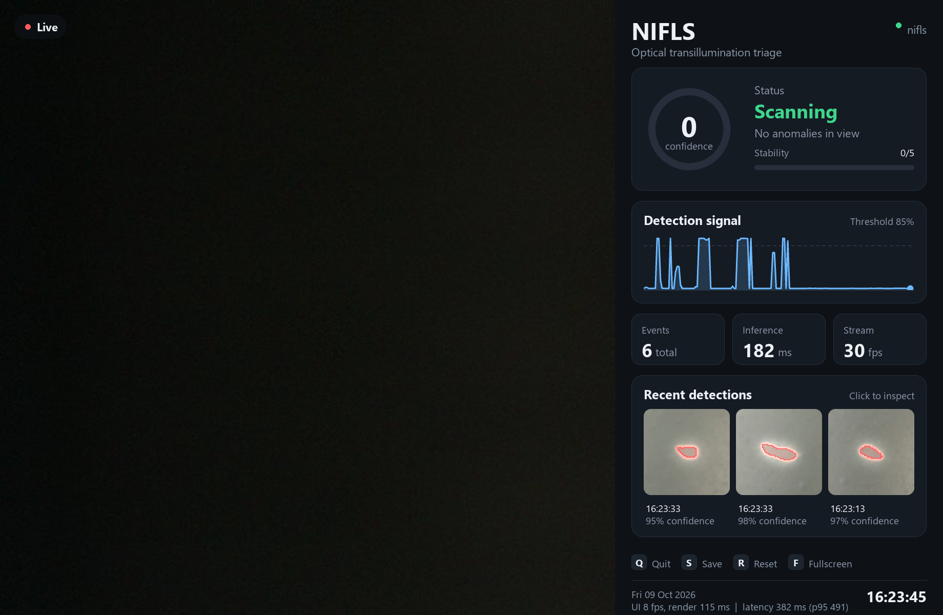
Software/experiment 4/nifls_captures/nifls_screenshot_20261009_162345.png
