joshua-naidoo/NIFLS/Software/experiment 4/nifls_captures/nifls_screenshot_20261010_155727.png

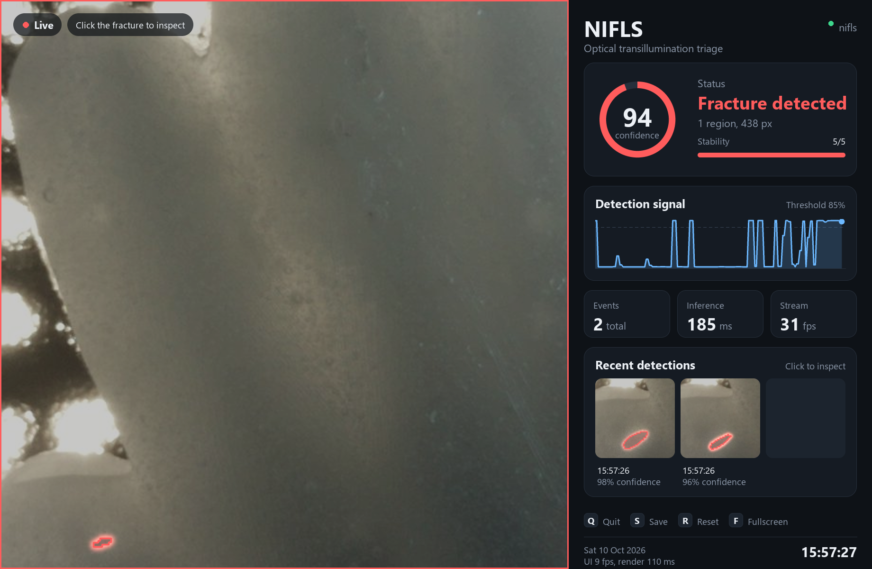
Software/experiment 4/nifls_captures/nifls_screenshot_20261010_155727.png
