joshua-naidoo/NIFLS/Software/experiment 4/training_images/fracture_s01_p16_20ms.jpg

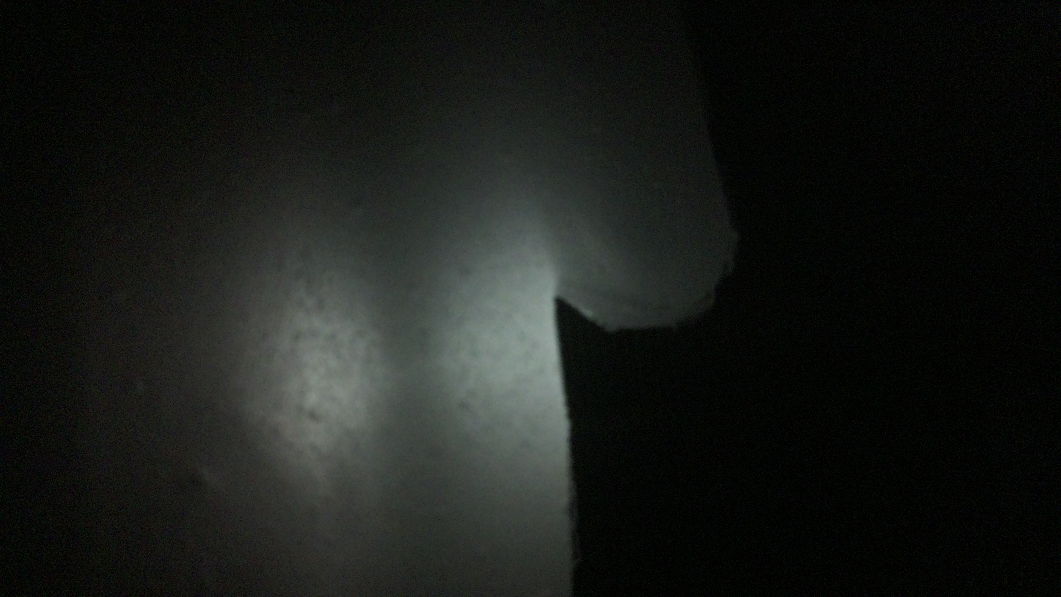
Software/experiment 4/training_images/fracture_s01_p16_20ms.jpg
