joshua-naidoo/NIFLS/Software/experiment 4/training_images/fracture_s01_p35_20ms.jpg

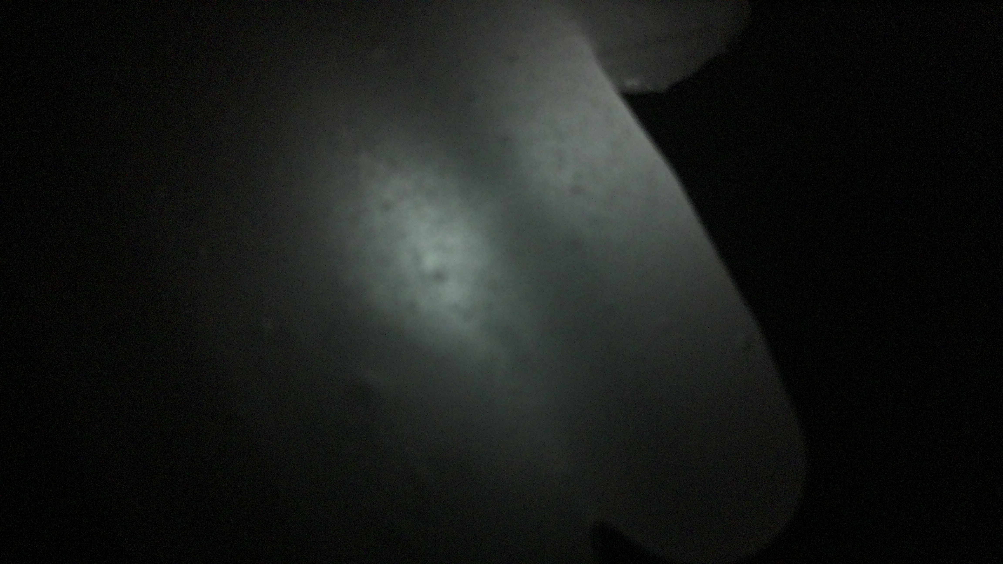
Software/experiment 4/training_images/fracture_s01_p35_20ms.jpg
