joshua-naidoo/NIFLS/Software/experiment 4/training_images/img_005.jpg

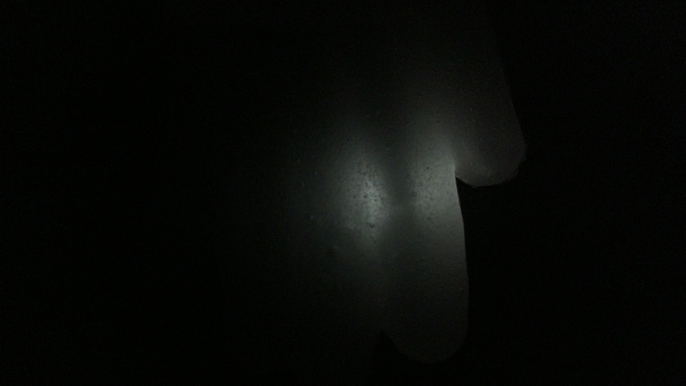
Software/experiment 4/training_images/img_005.jpg
