joshua-naidoo/NIFLS/Software/experiment 4/training_images/img_006.jpg

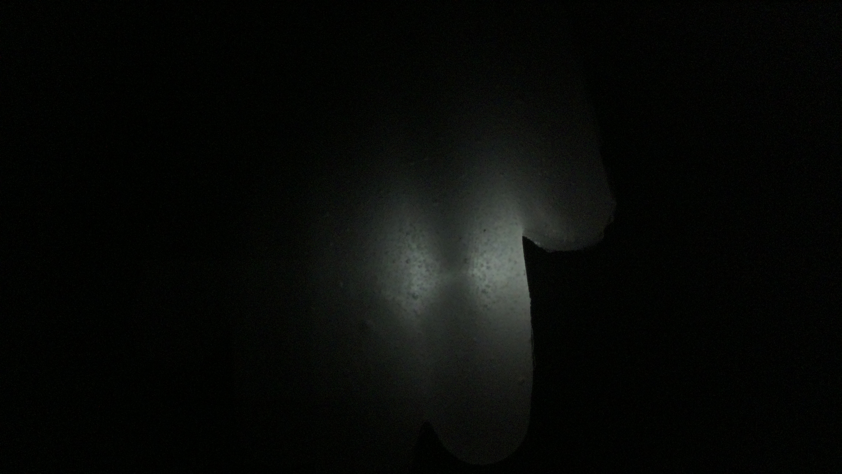
Software/experiment 4/training_images/img_006.jpg
