joshua-naidoo/NIFLS/Software/experiment 4/training_images/img_041.jpg

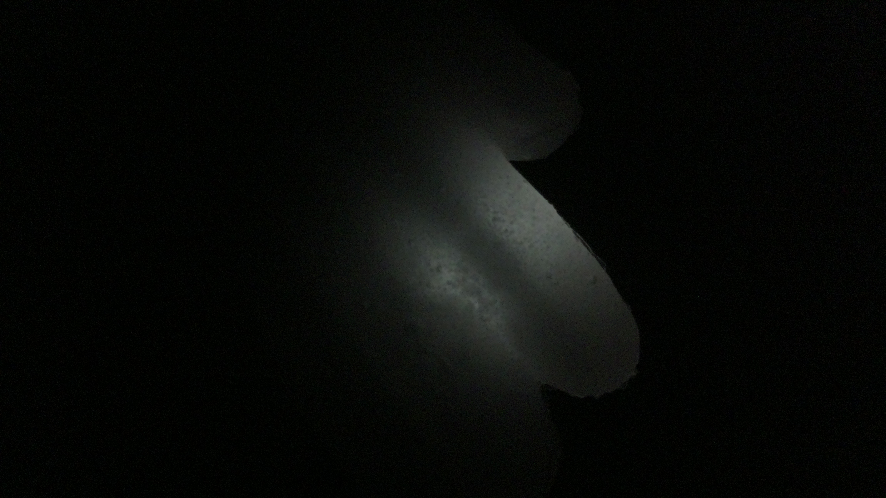
Software/experiment 4/training_images/img_041.jpg
