joshua-naidoo/NIFLS/Software/experiment 4/training_images/img_046.jpg

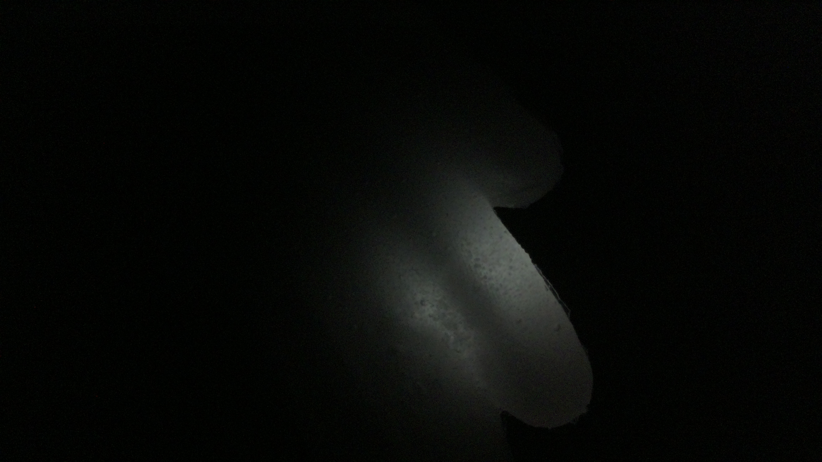
Software/experiment 4/training_images/img_046.jpg
