joshua-naidoo/NIFLS/Software/experiment 4/training_images/img_048.jpg

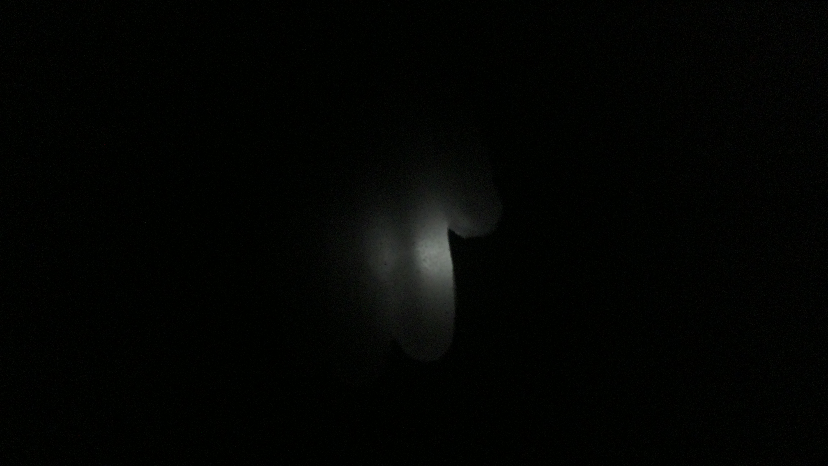
Software/experiment 4/training_images/img_048.jpg
