joshua-naidoo/NIFLS/Software/experiment 4/training_images/img_059.jpg

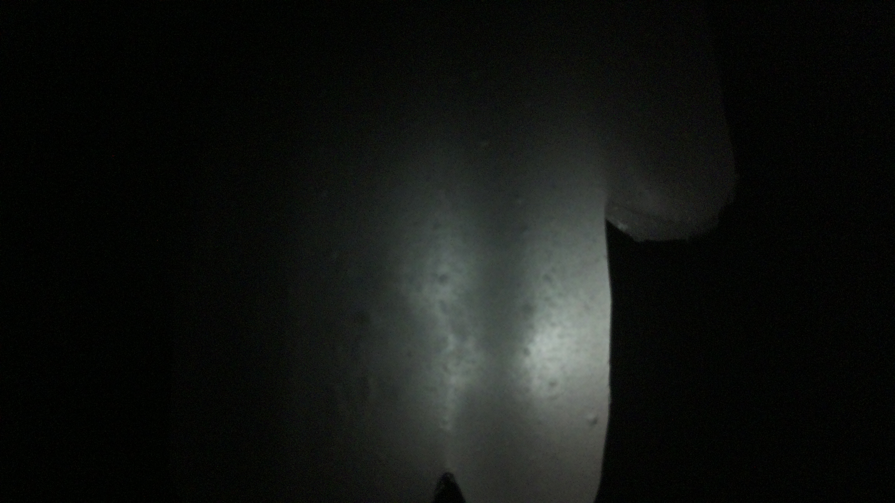
Software/experiment 4/training_images/img_059.jpg
