joshua-naidoo/NIFLS/Hardware/Baseplate/nifls_led_baseplate.kicad_sch

## KiCad design Hardware/Baseplate/nifls_led_baseplate.kicad_sch (2026-10-17)

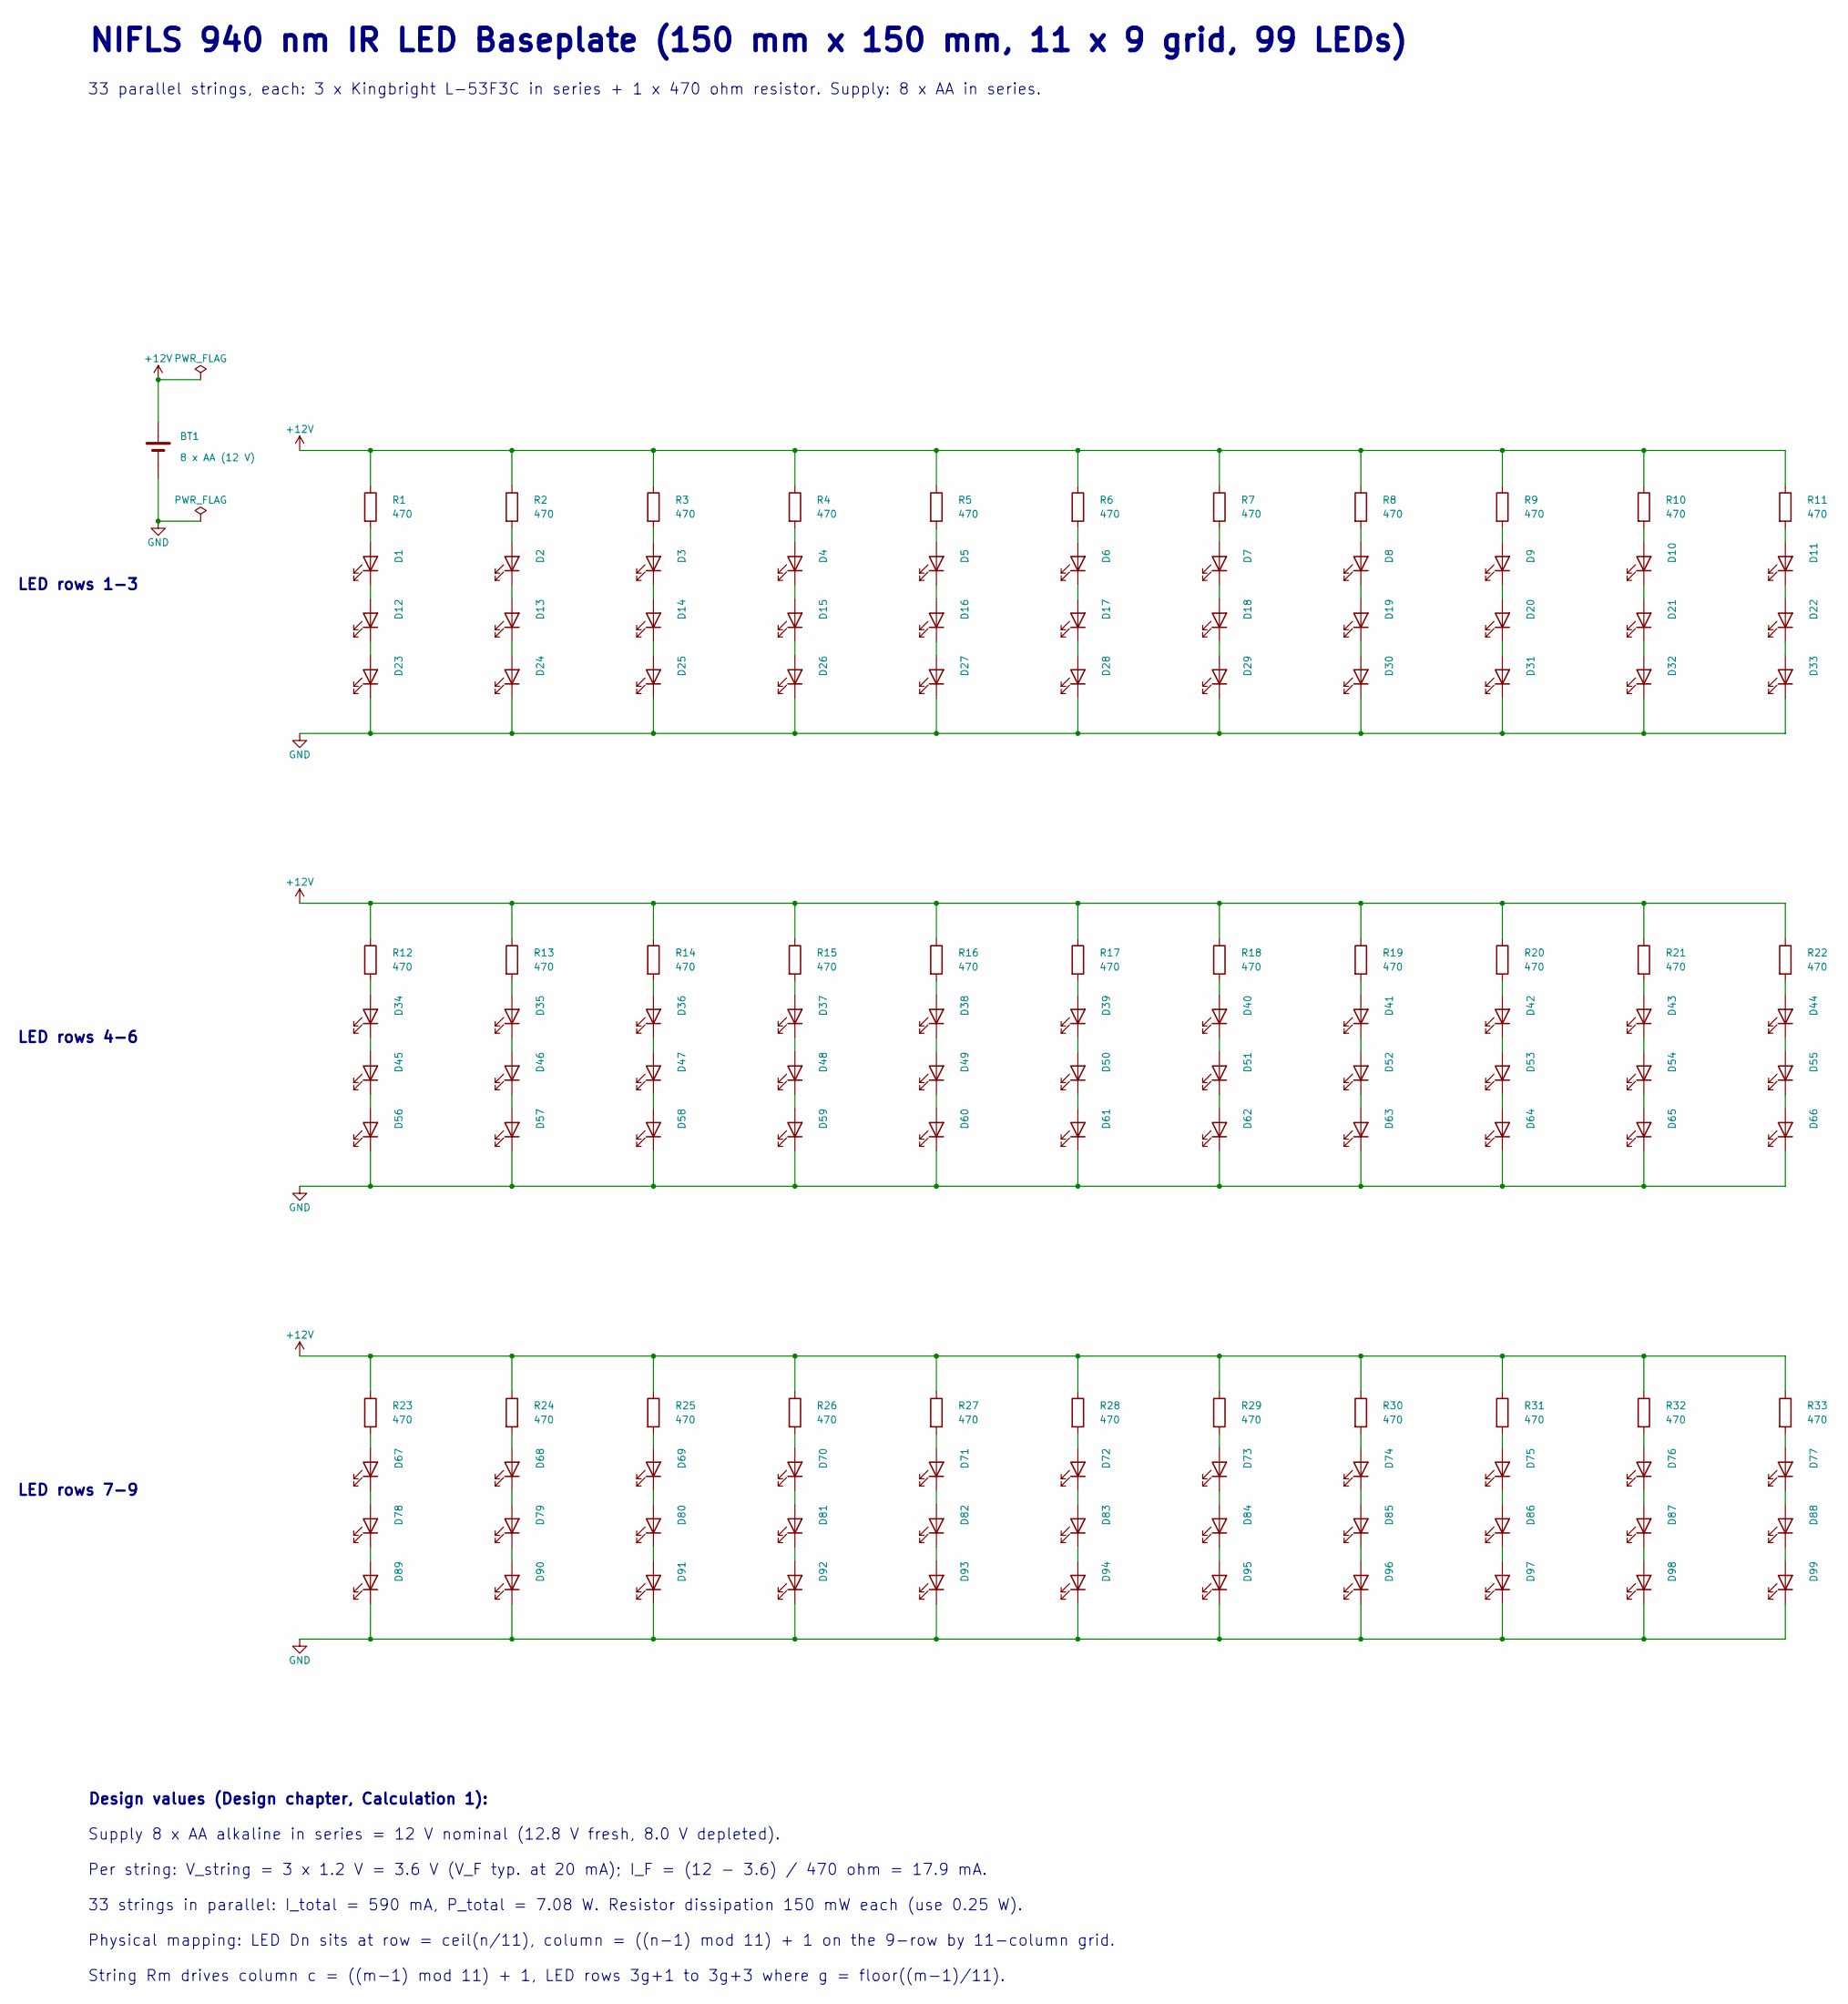
[picture p126: schematic nifls_led_baseplate.kicad_sch]

Parts:
BT1: 8 x AA (12 V)
D1, D2, D3, D4, D5, D6, D7, D8, D9, D10, D11, D12, D13, D14, D15, D16, D17, D18, D19, D20, D21, D22, D23, D24, D25, D26, D27, D28, D29, D30, D31, D32, D33, D34, D35, D36, D37, D38, D39, D40, D41, D42, D43, D44, D45, D46, D47, D48, D49, D50, D51, D52, D53, D54, D55, D56, D57, D58, D59, D60, D61, D62, D63, D64, D65, D66, D67, D68, D69, D70, D71, D72, D73, D74, D75, D76, D77, D78, D79, D80, D81, D82, D83, D84, D85, D86, D87, D88, D89, D90, D91, D92, D93, D94, D95, D96, D97, D98, D99: L-53F3C; LED_D5.0mm
R1, R2, R3, R4, R5, R6, R7, R8, R9, R10, R11, R12, R13, R14, R15, R16, R17, R18, R19, R20, R21, R22, R23, R24, R25, R26, R27, R28, R29, R30, R31, R32, R33: 470; R_Axial_DIN0207_L6.3mm_D2.5mm_P10.16mm_Horizontal

Connections:
+12V: BT1.1 (+), R1.1, R2.1, R3.1, R4.1, R5.1, R6.1, R7.1, R8.1, R9.1, R10.1, R11.1, R12.1, R13.1, R14.1, R15.1, R16.1, R17.1, R18.1, R19.1, R20.1, R21.1, R22.1, R23.1, R24.1, R25.1, R26.1, R27.1, R28.1, R29.1, R30.1, R31.1, R32.1, R33.1
GND: BT1.2 (-), D23.1 (K), D24.1 (K), D25.1 (K), D26.1 (K), D27.1 (K), D28.1 (K), D29.1 (K), D30.1 (K), D31.1 (K), D32.1 (K), D33.1 (K), D56.1 (K), D57.1 (K), D58.1 (K), D59.1 (K), D60.1 (K), D61.1 (K), D62.1 (K), D63.1 (K), D64.1 (K), D65.1 (K), D66.1 (K), D89.1 (K), D90.1 (K), D91.1 (K), D92.1 (K), D93.1 (K), D94.1 (K), D95.1 (K), D96.1 (K), D97.1 (K), D98.1 (K), D99.1 (K)
unnamed: D1.1 (K), D12.2 (A)
unnamed: D1.2 (A), R1.2
unnamed: D2.2 (A), R2.2
unnamed: D3.2 (A), R3.2
unnamed: D4.2 (A), R4.2
unnamed: D5.2 (A), R5.2
unnamed: D6.2 (A), R6.2
unnamed: D7.2 (A), R7.2
unnamed: D8.2 (A), R8.2
unnamed: D9.2 (A), R9.2
unnamed: D10.1 (K), D21.2 (A)
unnamed: D10.2 (A), R10.2
unnamed: D11.1 (K), D22.2 (A)
unnamed: D11.2 (A), R11.2
unnamed: D12.1 (K), D23.2 (A)
unnamed: D13.1 (K), D24.2 (A)
unnamed: D2.1 (K), D13.2 (A)
unnamed: D14.1 (K), D25.2 (A)
unnamed: D3.1 (K), D14.2 (A)
unnamed: D15.1 (K), D26.2 (A)
unnamed: D4.1 (K), D15.2 (A)
unnamed: D16.1 (K), D27.2 (A)
unnamed: D5.1 (K), D16.2 (A)
unnamed: D17.1 (K), D28.2 (A)
unnamed: D6.1 (K), D17.2 (A)
unnamed: D18.1 (K), D29.2 (A)
unnamed: D7.1 (K), D18.2 (A)
unnamed: D19.1 (K), D30.2 (A)
unnamed: D8.1 (K), D19.2 (A)
unnamed: D20.1 (K), D31.2 (A)
unnamed: D9.1 (K), D20.2 (A)
unnamed: D21.1 (K), D32.2 (A)
unnamed: D22.1 (K), D33.2 (A)
unnamed: D34.1 (K), D45.2 (A)
unnamed: D34.2 (A), R12.2
unnamed: D35.1 (K), D46.2 (A)
unnamed: D35.2 (A), R13.2
unnamed: D36.1 (K), D47.2 (A)
unnamed: D36.2 (A), R14.2
unnamed: D37.1 (K), D48.2 (A)
unnamed: D37.2 (A), R15.2
unnamed: D38.1 (K), D49.2 (A)
unnamed: D38.2 (A), R16.2
unnamed: D39.1 (K), D50.2 (A)
unnamed: D39.2 (A), R17.2
unnamed: D40.1 (K), D51.2 (A)
unnamed: D40.2 (A), R18.2
unnamed: D41.1 (K), D52.2 (A)
unnamed: D41.2 (A), R19.2
unnamed: D42.1 (K), D53.2 (A)
unnamed: D42.2 (A), R20.2
unnamed: D43.1 (K), D54.2 (A)
unnamed: D43.2 (A), R21.2
unnamed: D44.1 (K), D55.2 (A)
unnamed: D44.2 (A), R22.2
unnamed: D45.1 (K), D56.2 (A)
unnamed: D46.1 (K), D57.2 (A)
unnamed: D47.1 (K), D58.2 (A)
unnamed: D48.1 (K), D59.2 (A)
unnamed: D49.1 (K), D60.2 (A)
unnamed: D50.1 (K), D61.2 (A)
unnamed: D51.1 (K), D62.2 (A)
unnamed: D52.1 (K), D63.2 (A)
unnamed: D53.1 (K), D64.2 (A)
unnamed: D54.1 (K), D65.2 (A)
unnamed: D55.1 (K), D66.2 (A)
unnamed: D67.1 (K), D78.2 (A)
unnamed: D67.2 (A), R23.2
unnamed: D68.1 (K), D79.2 (A)
unnamed: D68.2 (A), R24.2
unnamed: D69.1 (K), D80.2 (A)
unnamed: D69.2 (A), R25.2
unnamed: D70.1 (K), D81.2 (A)
unnamed: D70.2 (A), R26.2
unnamed: D71.1 (K), D82.2 (A)
unnamed: D71.2 (A), R27.2
unnamed: D72.1 (K), D83.2 (A)
unnamed: D72.2 (A), R28.2
unnamed: D73.1 (K), D84.2 (A)
unnamed: D73.2 (A), R29.2
unnamed: D74.1 (K), D85.2 (A)
unnamed: D74.2 (A), R30.2
unnamed: D75.1 (K), D86.2 (A)
unnamed: D75.2 (A), R31.2
unnamed: D76.1 (K), D87.2 (A)
unnamed: D76.2 (A), R32.2
unnamed: D77.1 (K), D88.2 (A)
unnamed: D77.2 (A), R33.2
unnamed: D78.1 (K), D89.2 (A)
unnamed: D79.1 (K), D90.2 (A)
unnamed: D80.1 (K), D91.2 (A)
unnamed: D81.1 (K), D92.2 (A)
unnamed: D82.1 (K), D93.2 (A)
unnamed: D83.1 (K), D94.2 (A)
unnamed: D84.1 (K), D95.2 (A)
unnamed: D85.1 (K), D96.2 (A)
unnamed: D86.1 (K), D97.2 (A)
unnamed: D87.1 (K), D98.2 (A)
unnamed: D88.1 (K), D99.2 (A)

Notes on the sheet:
Physical mapping: LED Dn sits at row = ceil(n/11), column = ((n-1) mod 11) + 1 on the 9-row by 11-column grid.
33 parallel strings, each: 3 x Kingbright L-53F3C in series + 1 x 470 ohm resistor. Supply: 8 x AA in series.
NIFLS 940 nm IR LED Baseplate (150 mm x 150 mm, 11 x 9 grid, 99 LEDs)
Design values (Design chapter, Calculation 1):
LED rows 7-9
Supply 8 x AA alkaline in series = 12 V nominal (12.8 V fresh, 8.0 V depleted).
LED rows 4-6
33 strings in parallel: I_total = 590 mA, P_total = 7.08 W. Resistor dissipation 150 mW each (use 0.25 W).
LED rows 1-3
Per string: V_string = 3 x 1.2 V = 3.6 V (V_F typ. at 20 mA); I_F = (12 - 3.6) / 470 ohm = 17.9 mA.
String Rm drives column c = ((m-1) mod 11) + 1, LED rows 3g+1 to 3g+3 where g = floor((m-1)/11).
