joshua-naidoo/NIFLS/(commit log)

2026-10-17 Added initial files
    [host_latency_log.csv]
2026-10-17 Added hardware folder
    [host_latency_log.csv]
2026-10-17 Added hardware files
    [01_diffuser_frame.step, 01_diffuser_frame.stl, 01_mold_lower_MINI_DIAGONAL.3mf, 01_mold_lower_MINI_DIAGONAL.stl, 01_pi_base.step, 01_pi_base.stl, 02_LED_substrate.step, 02_LED_substrate.stl]
2026-10-27 Added per frame scores for experiment 4
    [exp4_v3_cv_per_frame.csv]
2026-10-27 Added experiment 1 and 2 files
    [exp1_fit.csv, exp2_per_position.csv, frames.csv]
